Matei77/RootKB/README.md

# RootKB - By Matei Ionescu

You can read about the project at: https://ocw.cs.pub.ro/courses/pm/prj2024/ccontasel/matei.ionescu0703

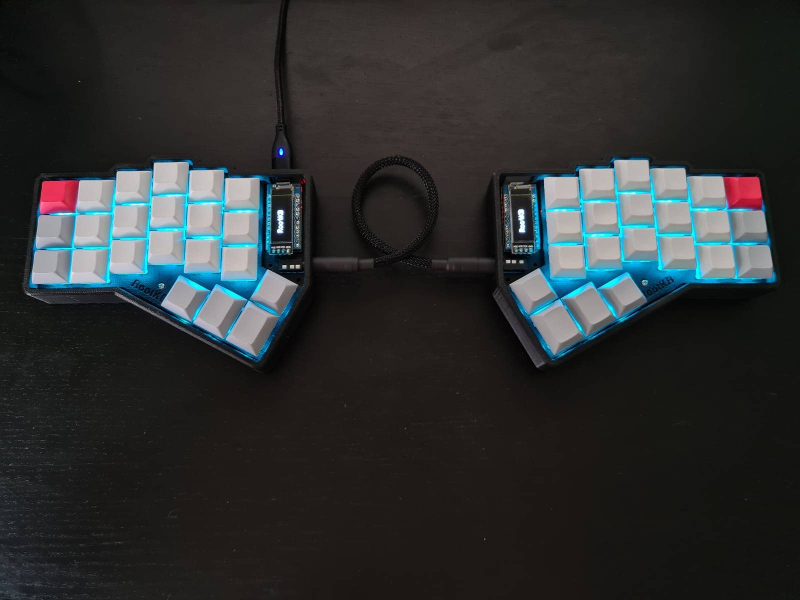
[picture p1: docs/images/final-result.jpeg]
keyboard
