Matei77/RootKB/Characters-Layout/keyboard-layout.png

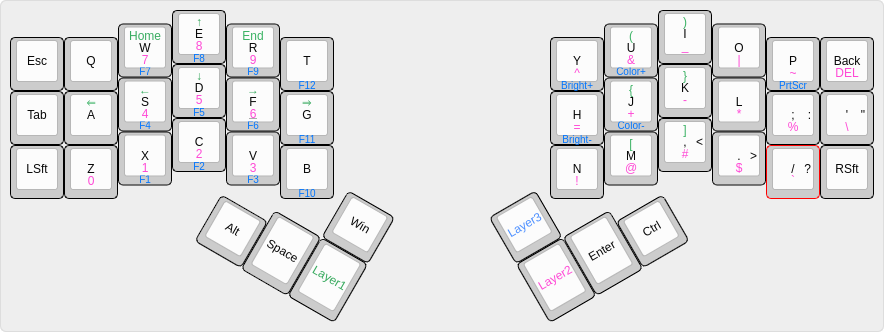
Characters-Layout/keyboard-layout.png
