Matei77/RootKB/docs/images/Block-diagram.png

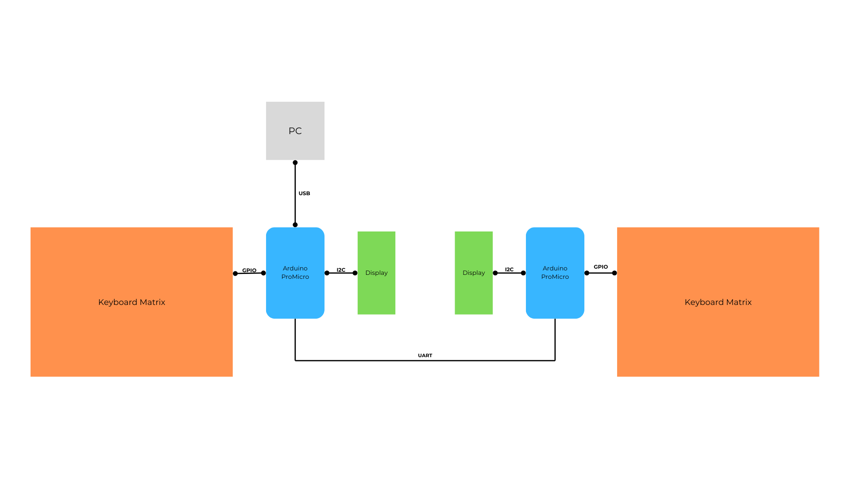
docs/images/Block-diagram.png
