Matei77/RootKB/docs/images/Case-Left.png

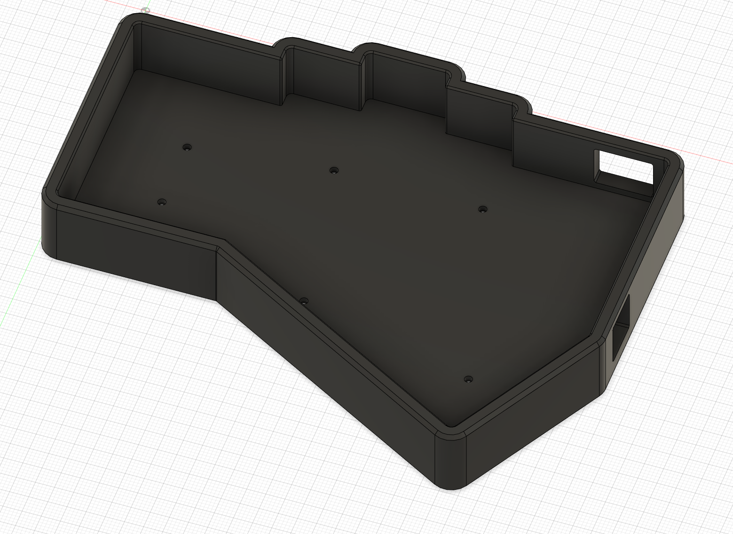
docs/images/Case-Left.png
