Matei77/RootKB/docs/images/Case-Right.png

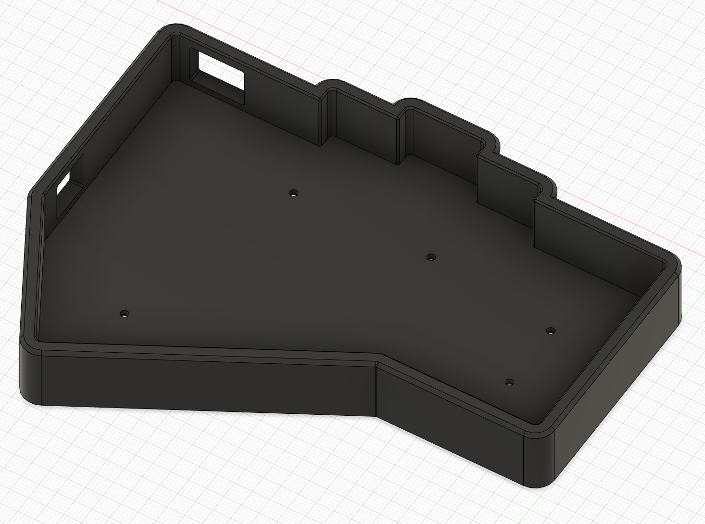
docs/images/Case-Right.png
