Matei77/RootKB/docs/images/ergogen-layout.png

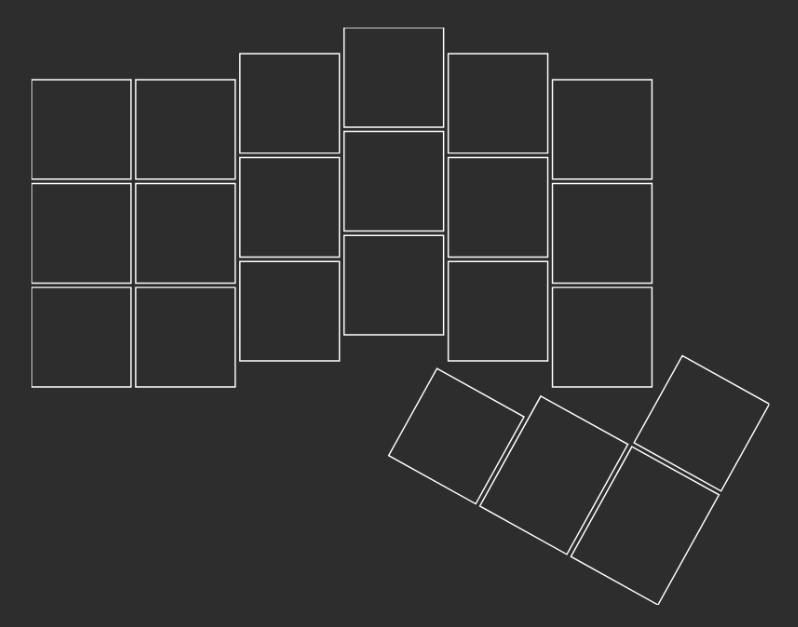
docs/images/ergogen-layout.png
