Matei77/RootKB/docs/images/final-keys-layout.jpeg

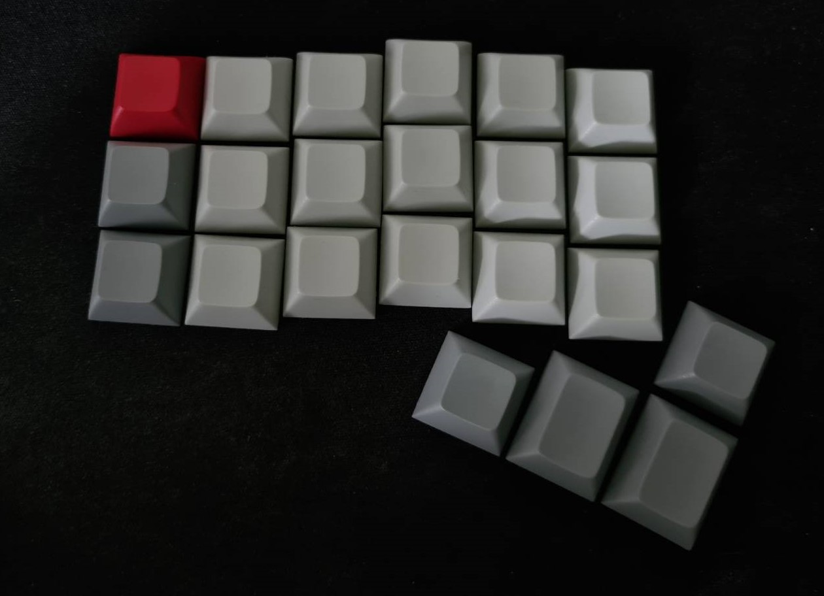
docs/images/final-keys-layout.jpeg
