Matei77/RootKB/docs/images/gantt.png

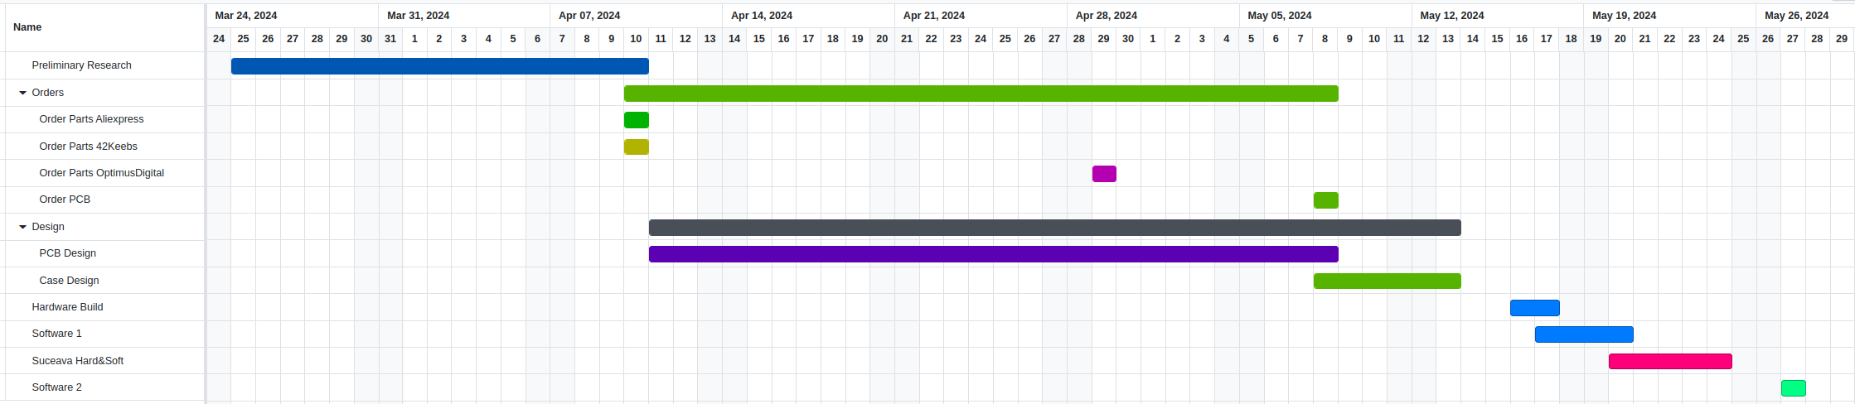
docs/images/gantt.png
