Matei77/RootKB/docs/images/layout-trail-1.jpeg

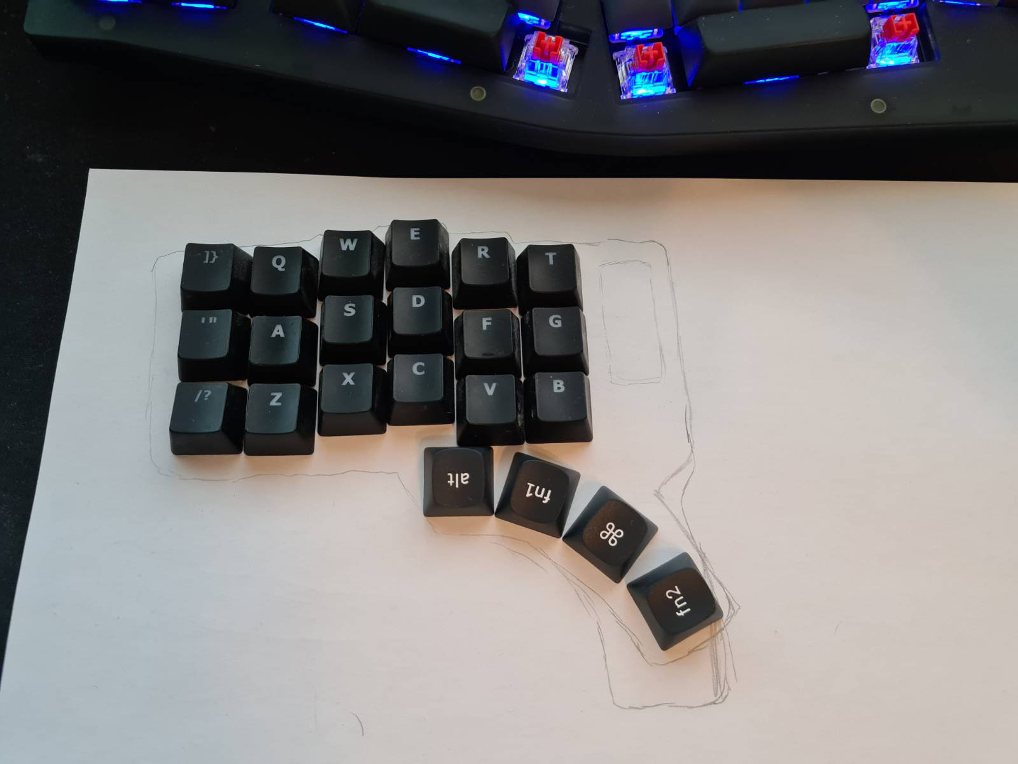
docs/images/layout-trail-1.jpeg
