Matei77/RootKB/docs/images/layout-trail-2.jpeg

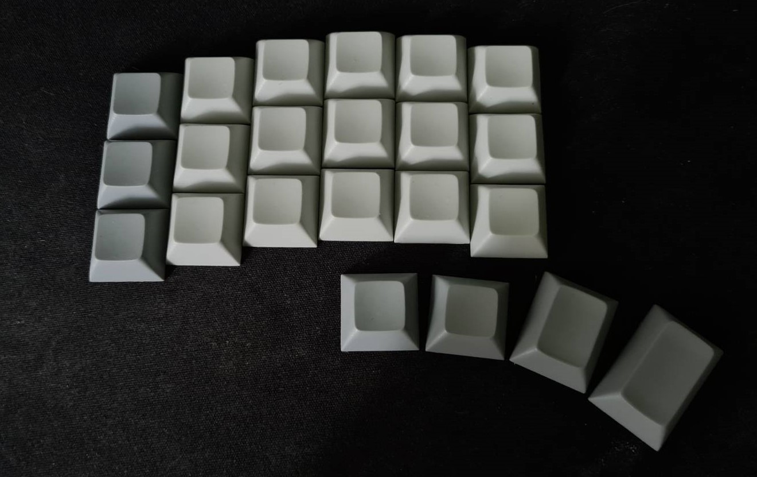
docs/images/layout-trail-2.jpeg
