Matei77/RootKB/docs/images/measuring-layout.jpeg

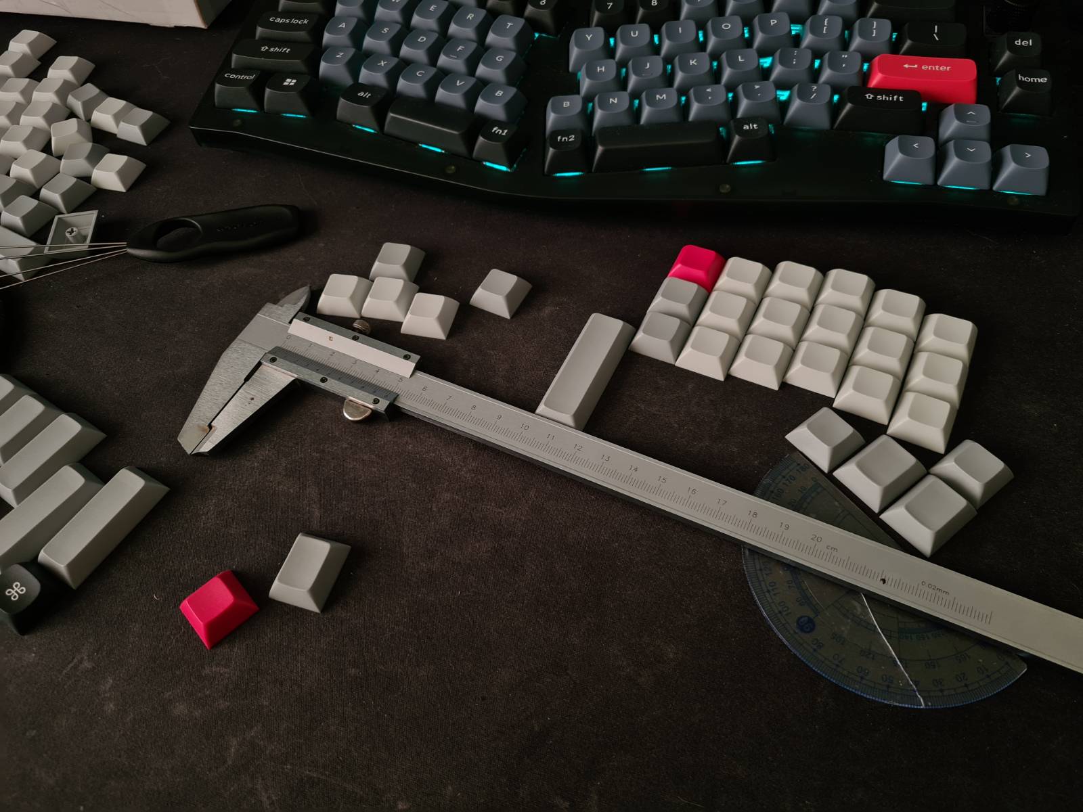
docs/images/measuring-layout.jpeg
