Matei77/RootKB/docs/images/PCB-Left-Back.png

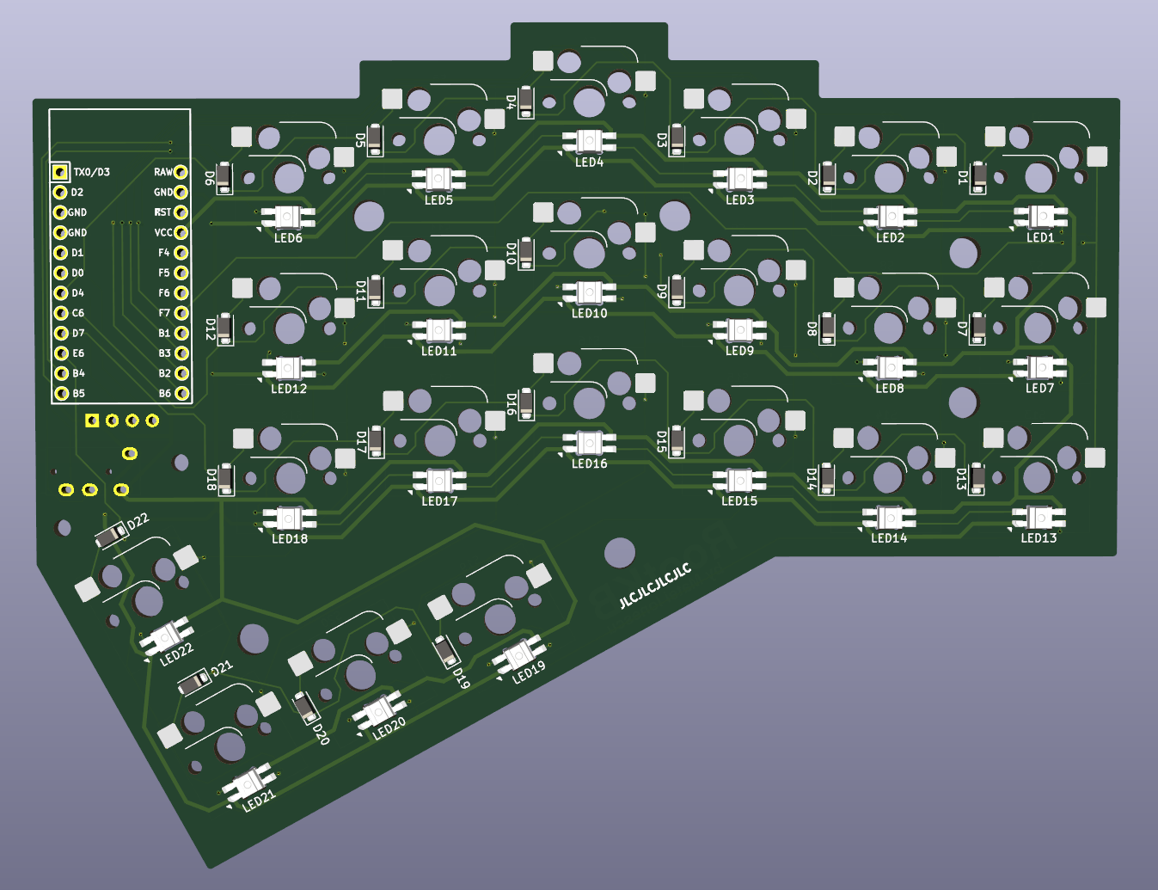
docs/images/PCB-Left-Back.png
