Matei77/RootKB/docs/images/PCB-Left-Front.png

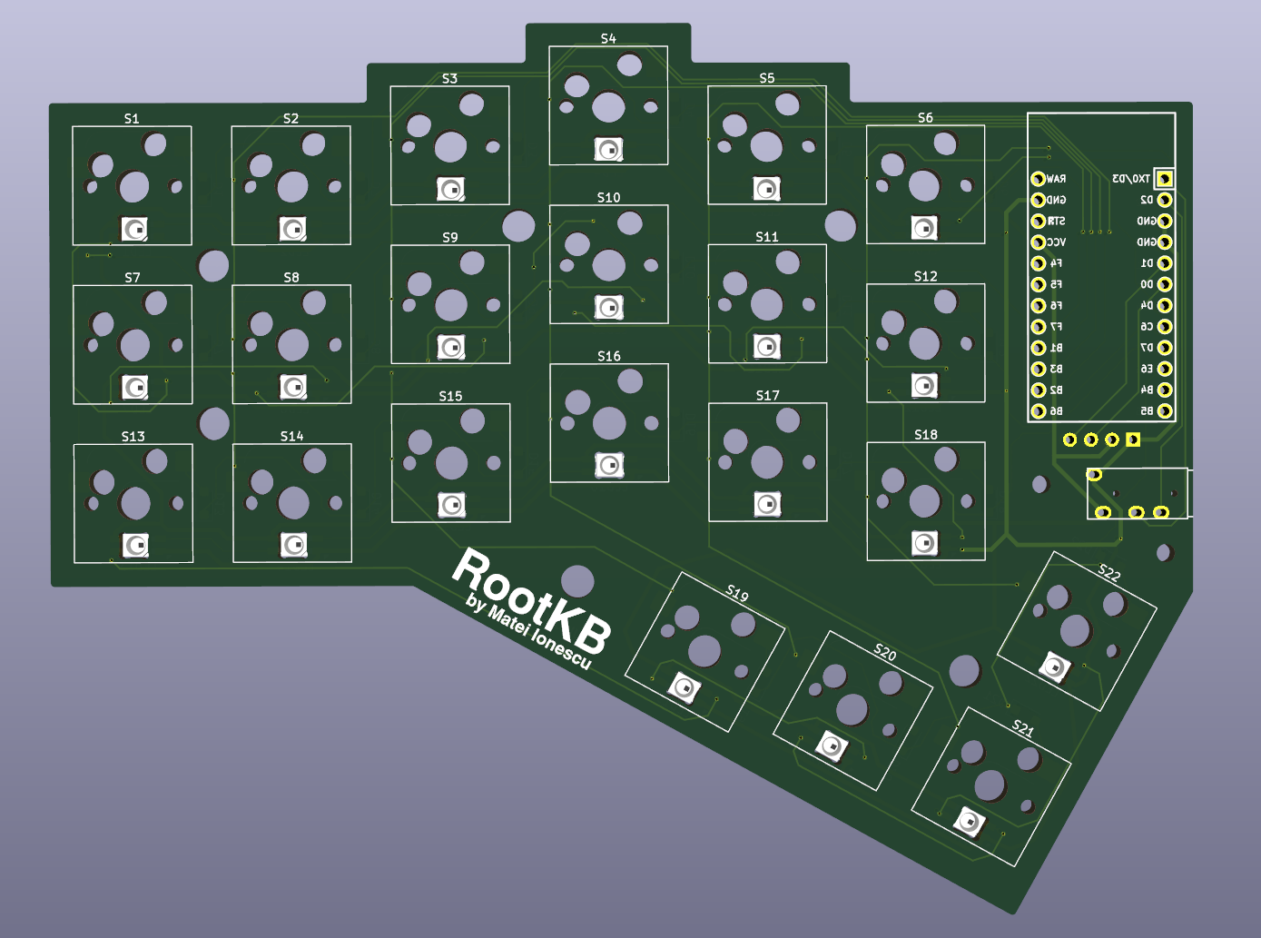
docs/images/PCB-Left-Front.png
