Matei77/RootKB/docs/images/PCB-Left.png

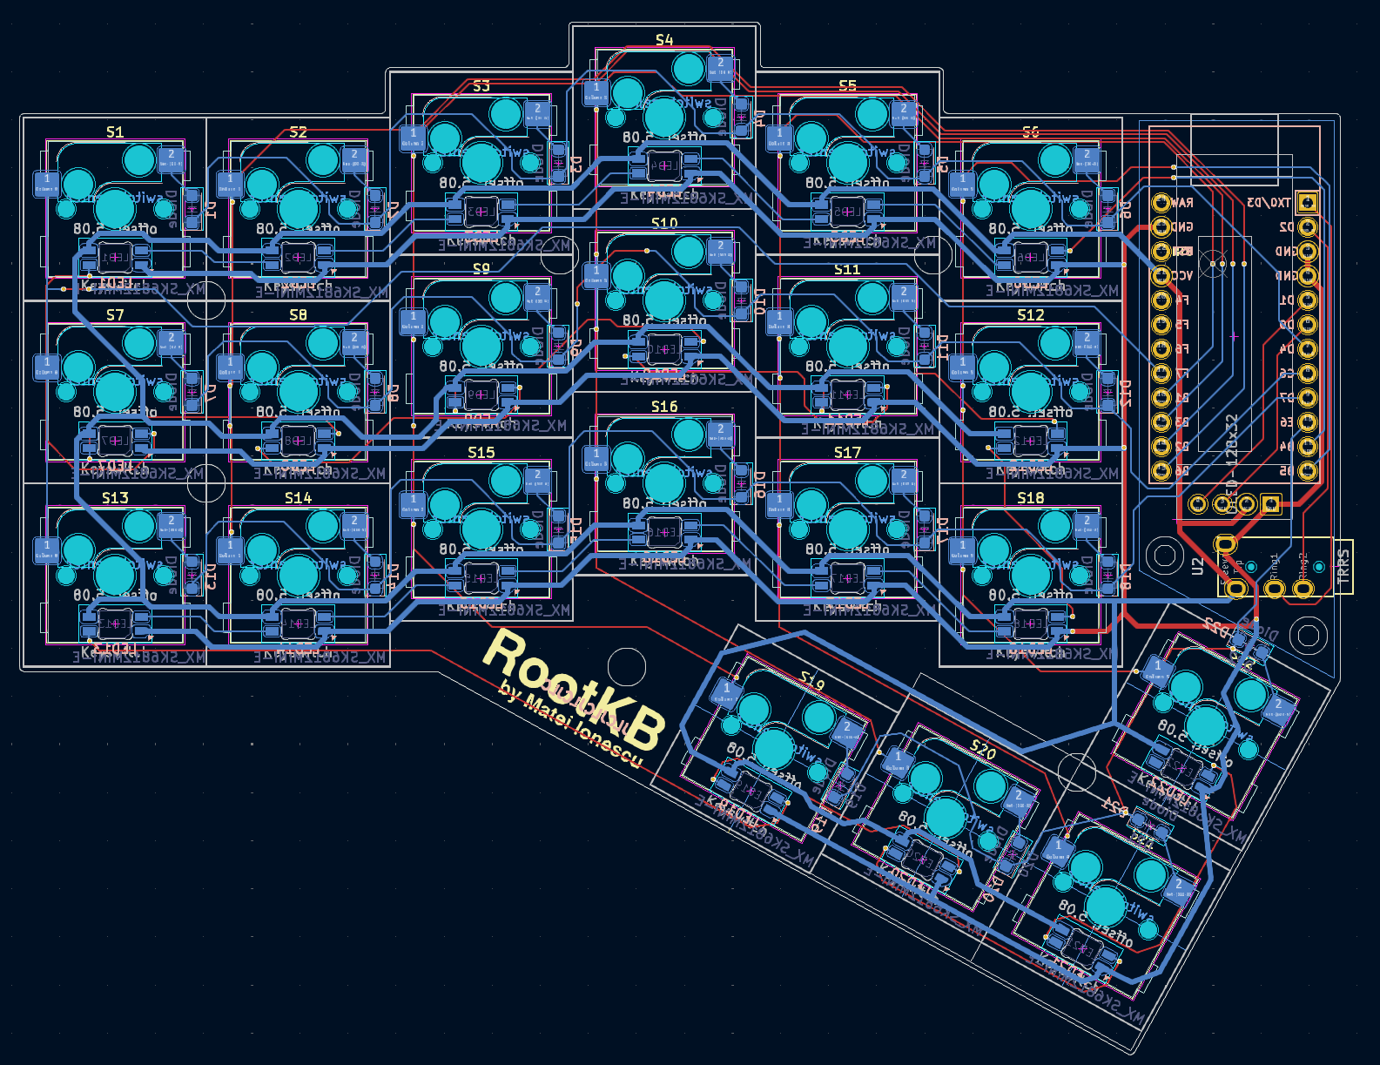
docs/images/PCB-Left.png
