Matei77/RootKB/docs/images/PCB-Right-Back.png

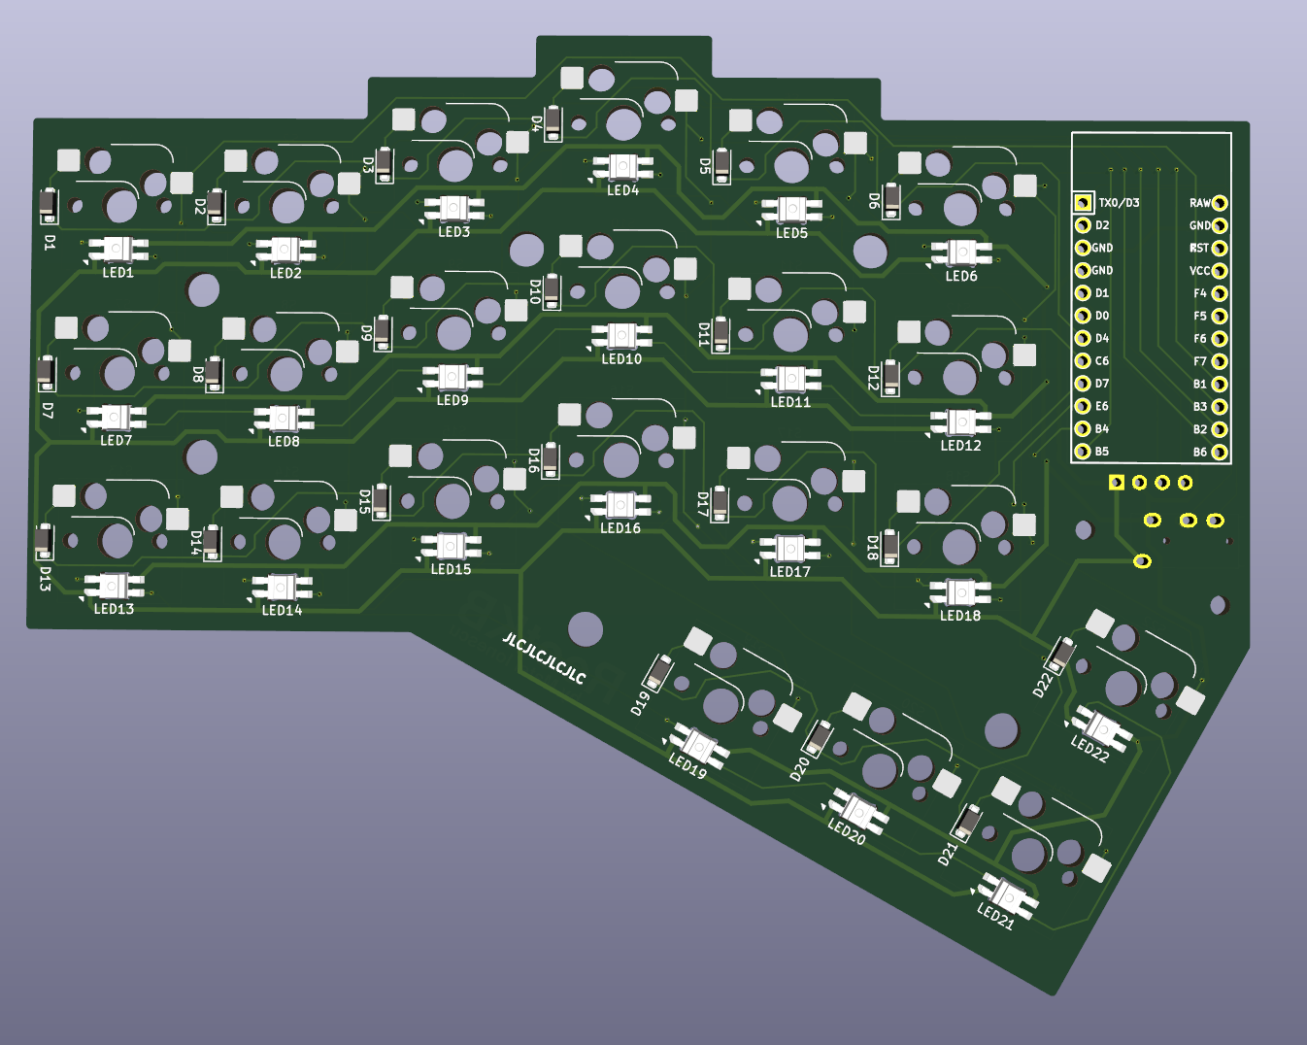
docs/images/PCB-Right-Back.png
