Matei77/RootKB/docs/images/PCB-Right-Front.png

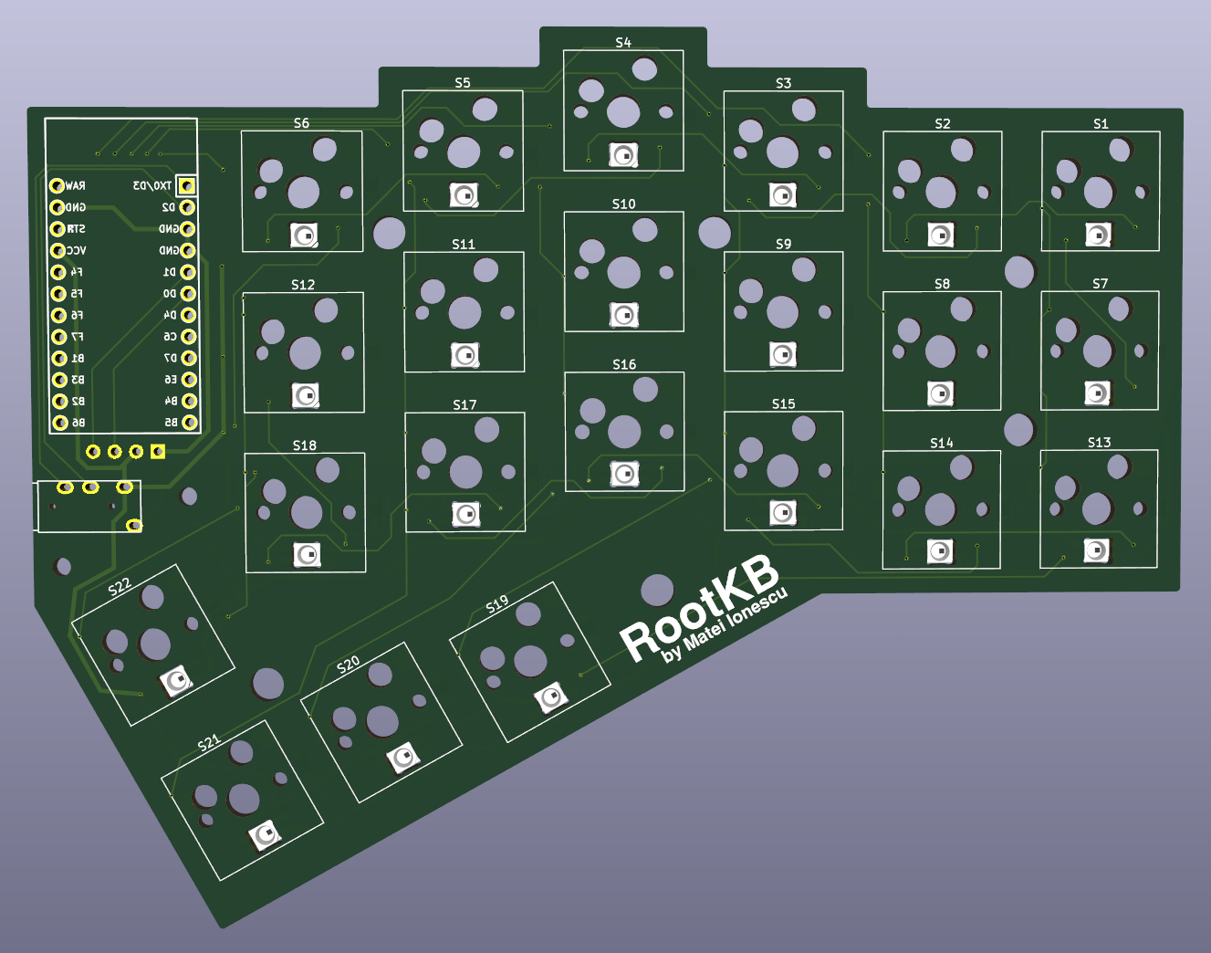
docs/images/PCB-Right-Front.png
