Matei77/RootKB/docs/images/PCB-Right.png

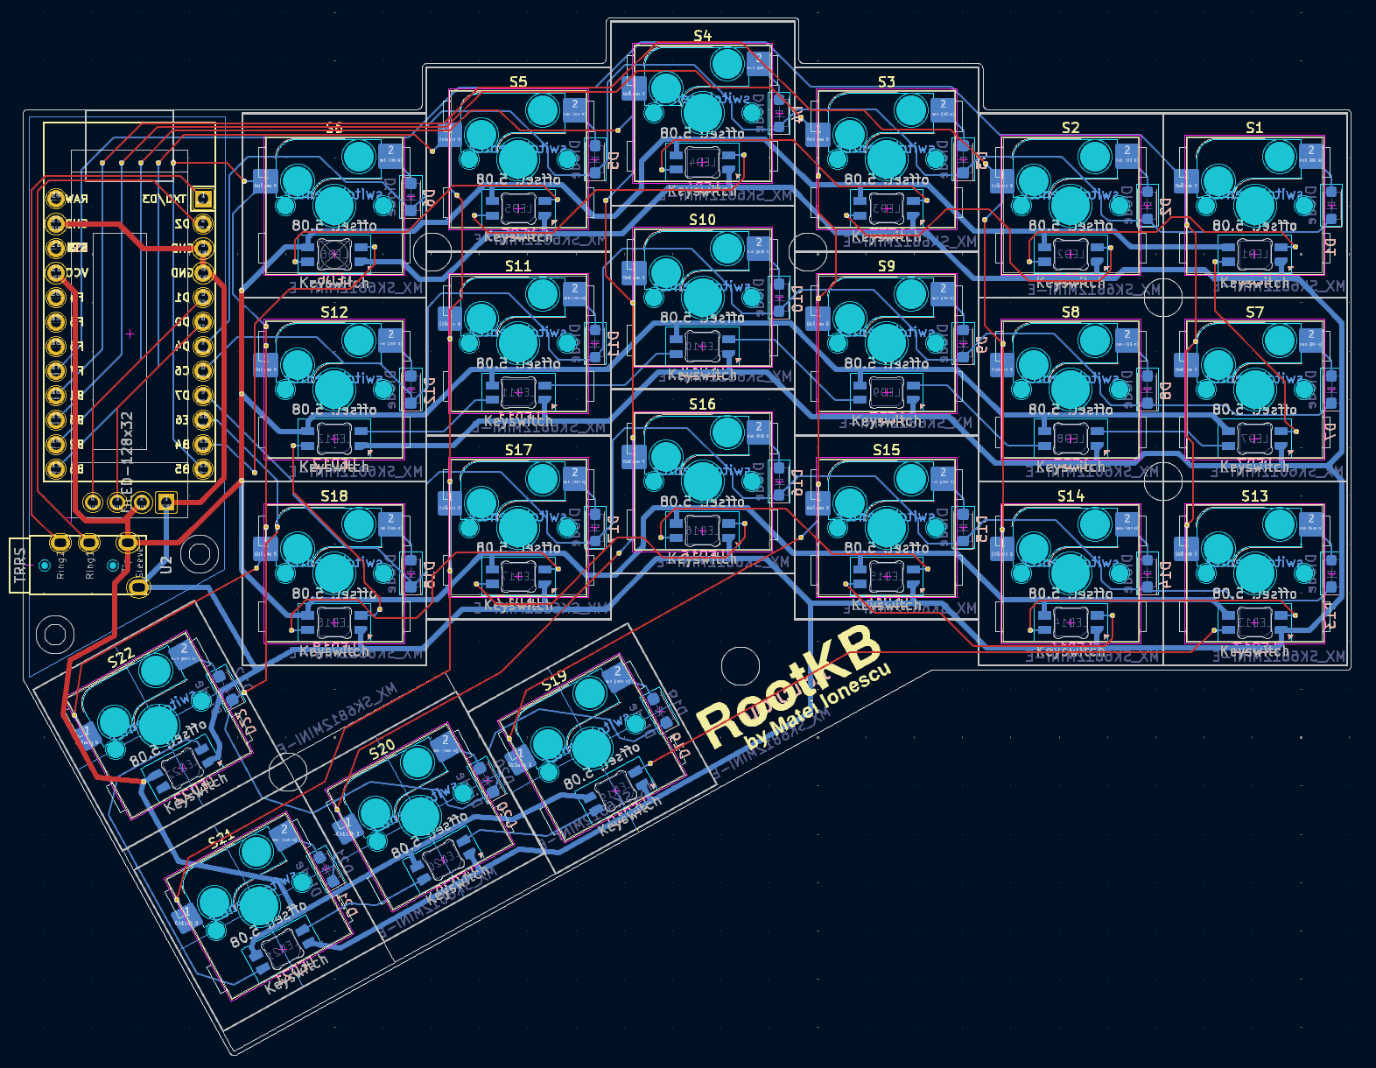
docs/images/PCB-Right.png
