Matei77/RootKB/docs/images/physical-pcbs.jpeg

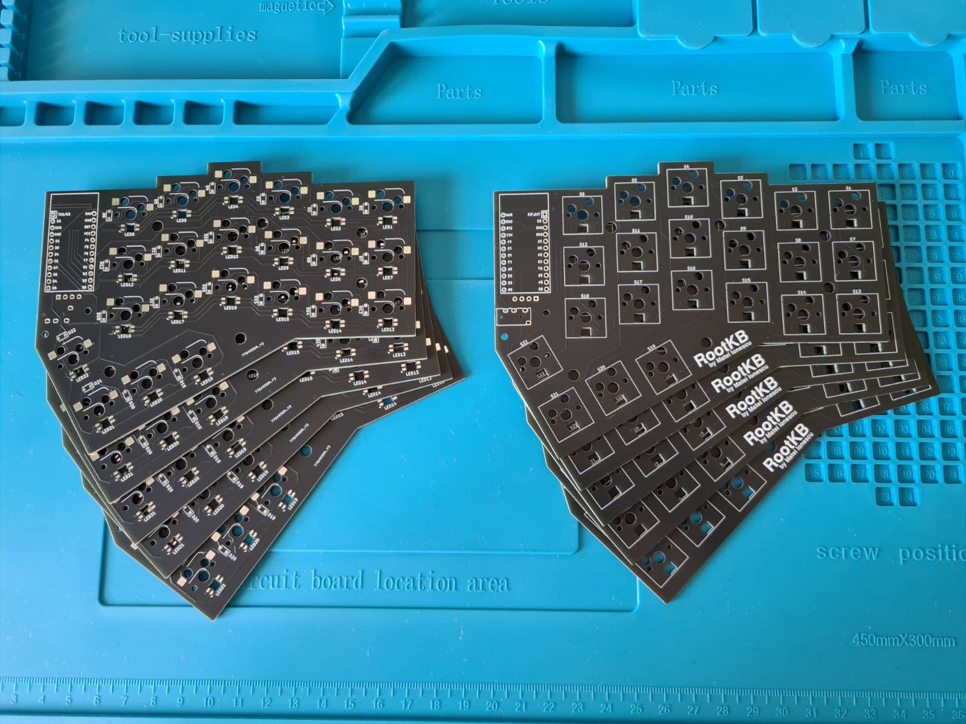
docs/images/physical-pcbs.jpeg
