Matei77/RootKB/docs/images/Plate-Left.png

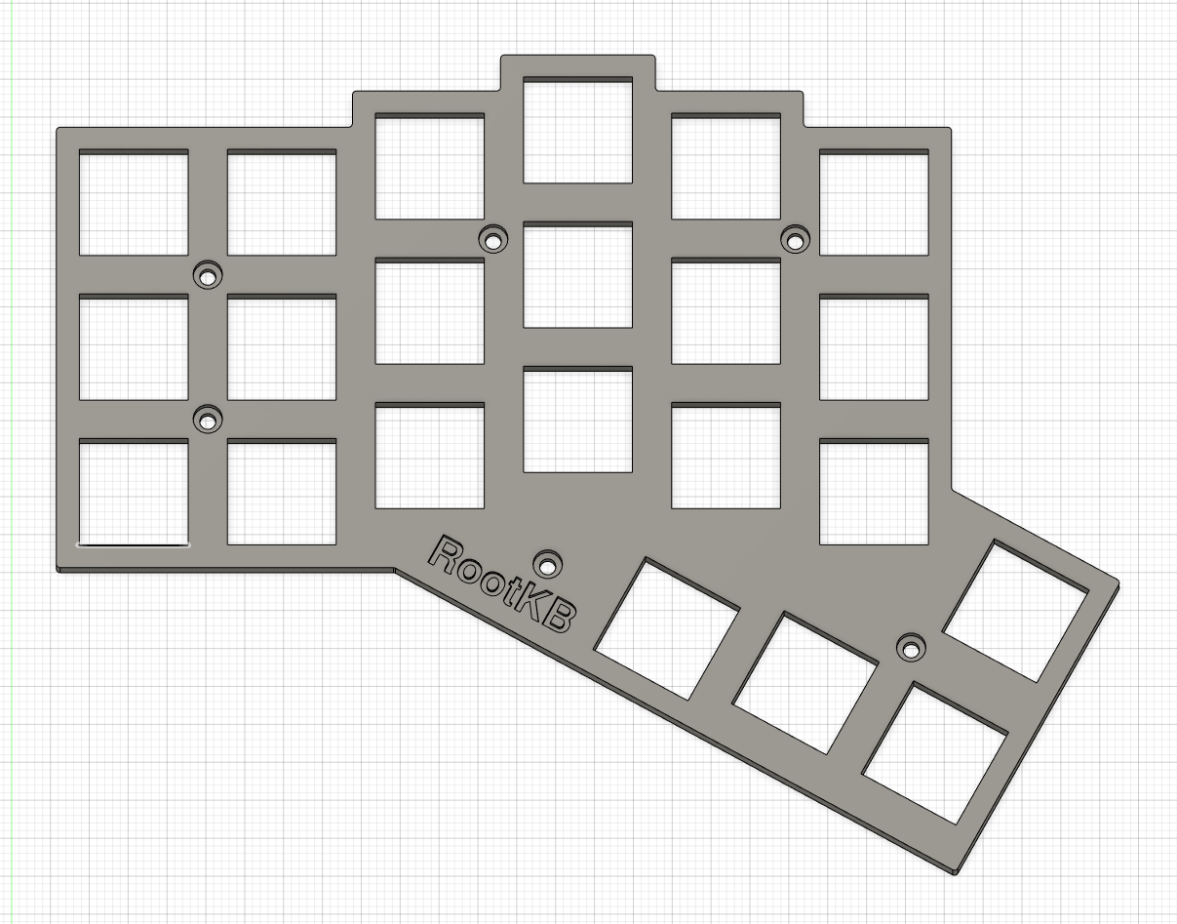
docs/images/Plate-Left.png
