Matei77/RootKB/docs/images/Plate-Right.png

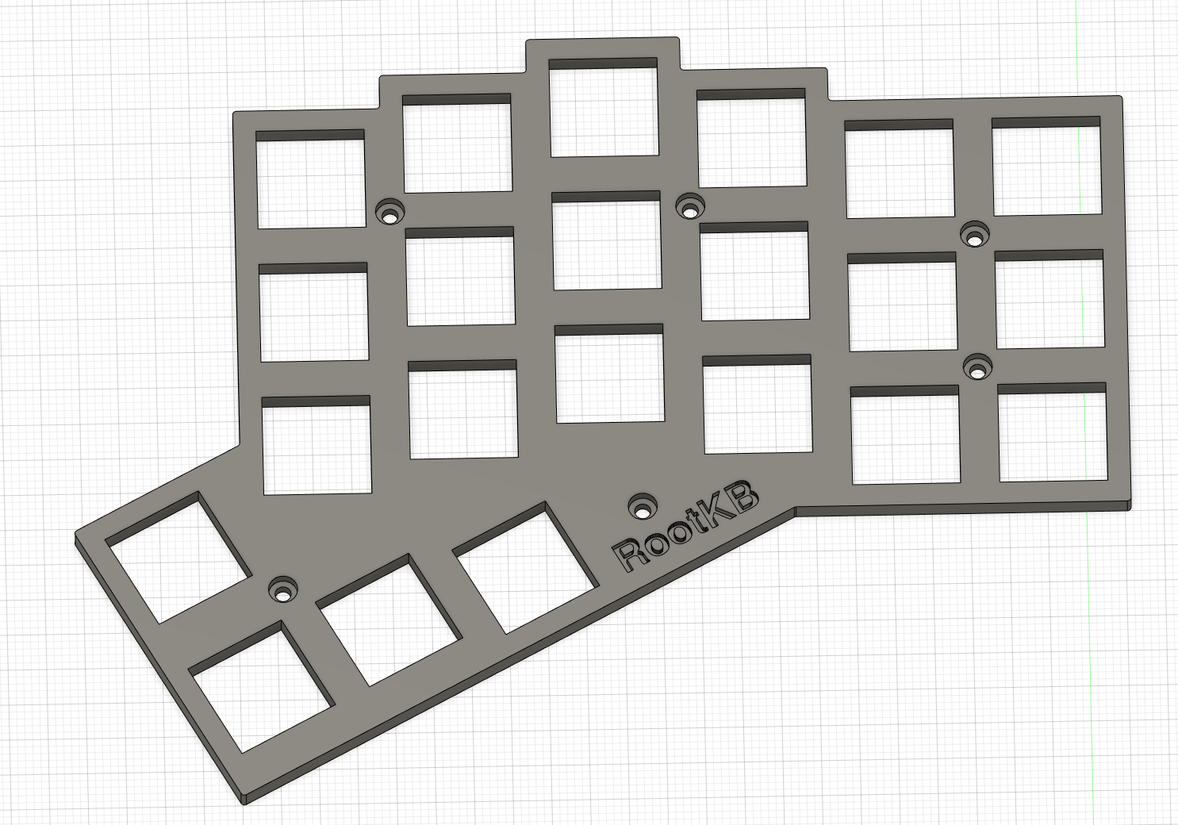
docs/images/Plate-Right.png
