Matei77/RootKB/docs/images/Remington_2_typewriter_keyboard-1878.jpg

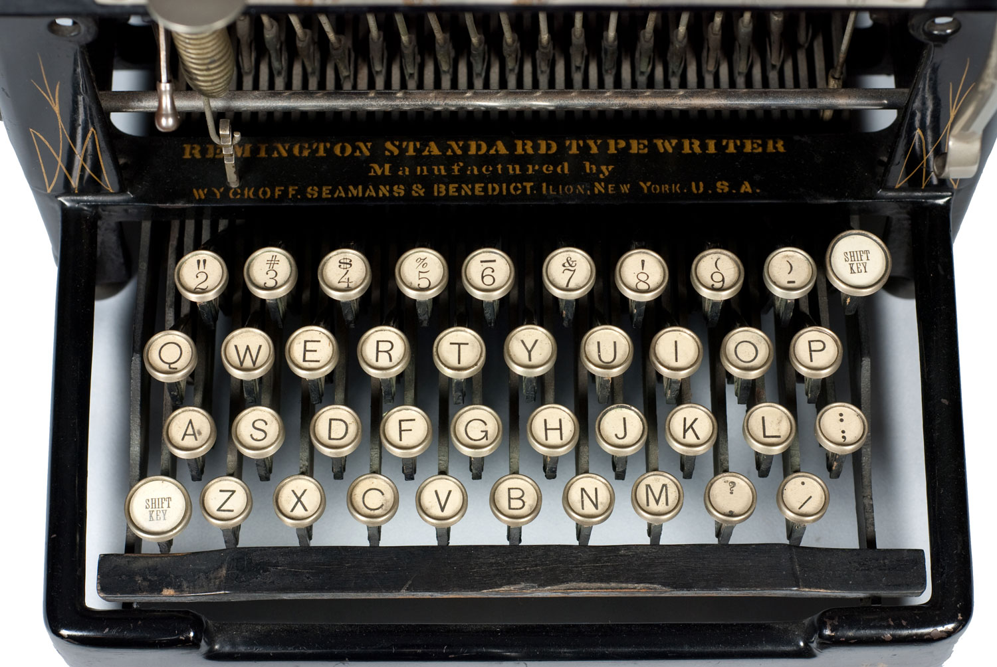
docs/images/Remington_2_typewriter_keyboard-1878.jpg
