Matei77/RootKB/docs/images/Schematic-Left.png

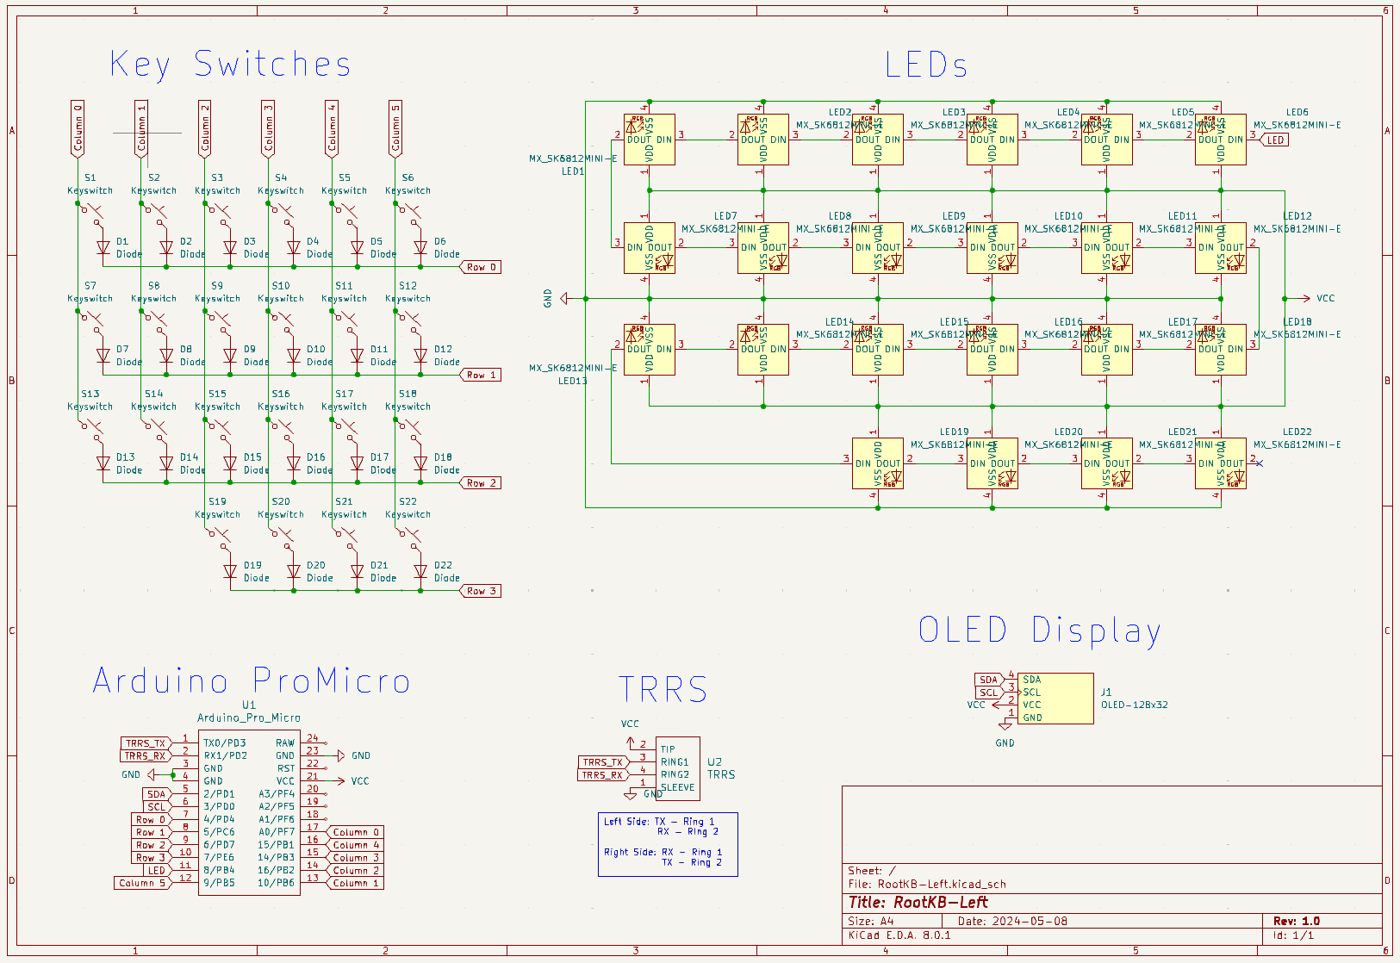
docs/images/Schematic-Left.png
