Matei77/RootKB/docs/images/Schematic-Right.png

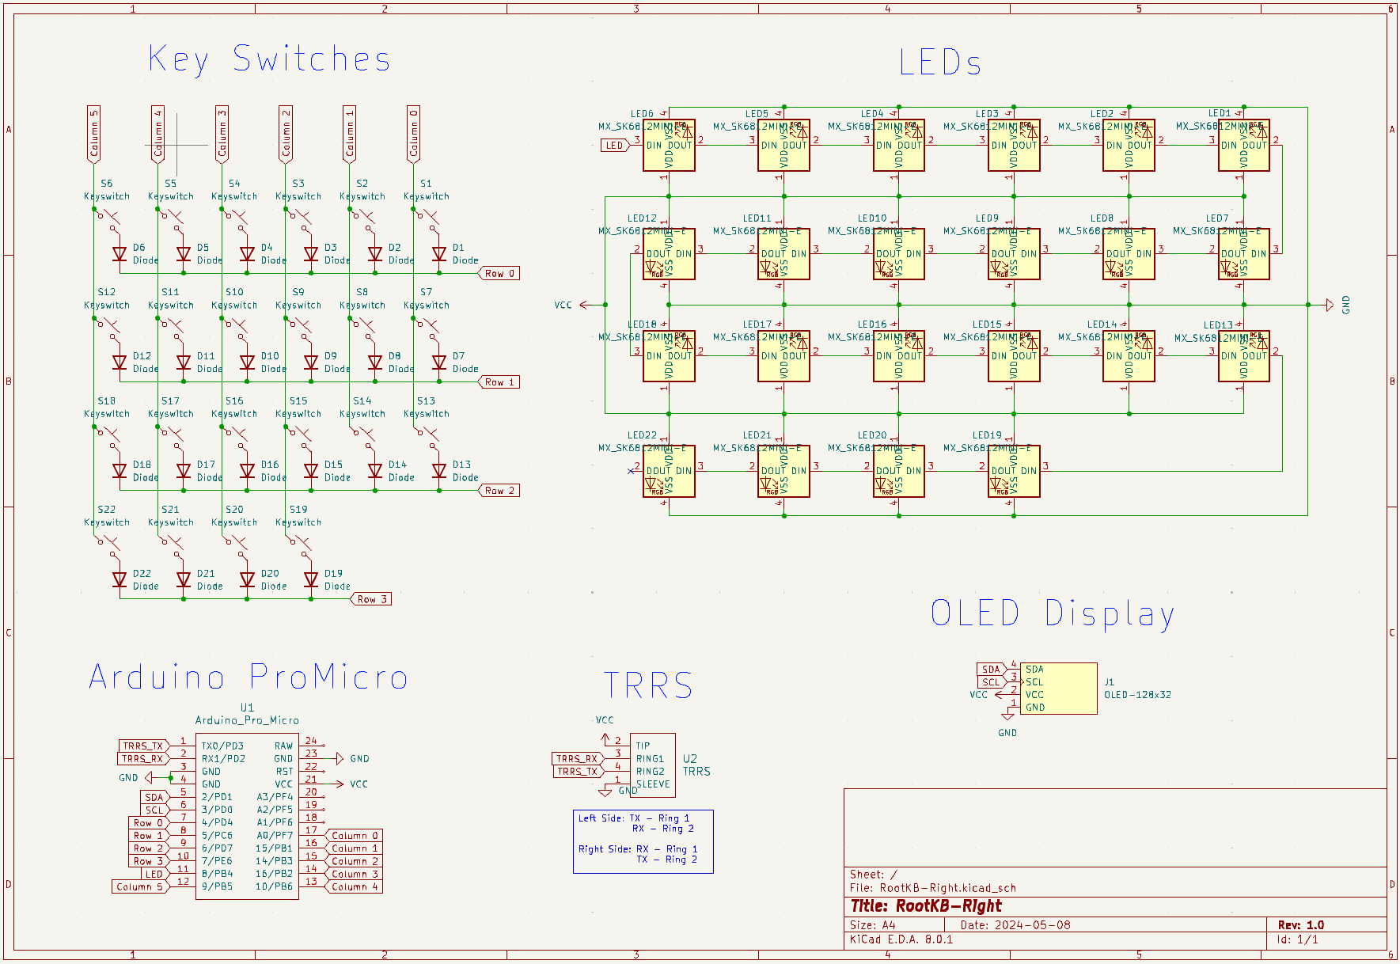
docs/images/Schematic-Right.png
