Matei77/RootKB/docs/images/split.jpg

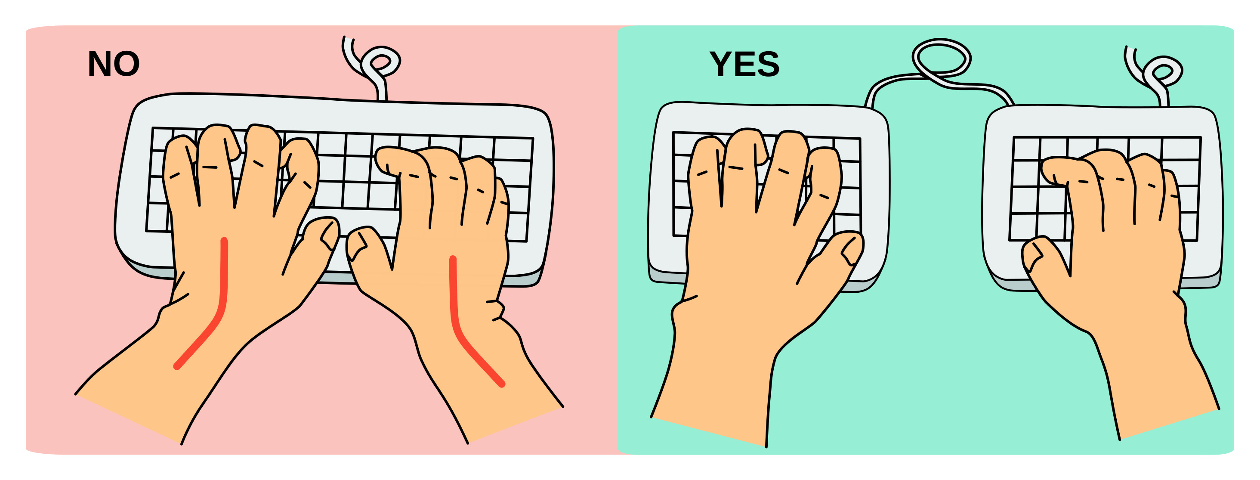
docs/images/split.jpg
