Matei77/RootKB/docs/images/stagger.jpg

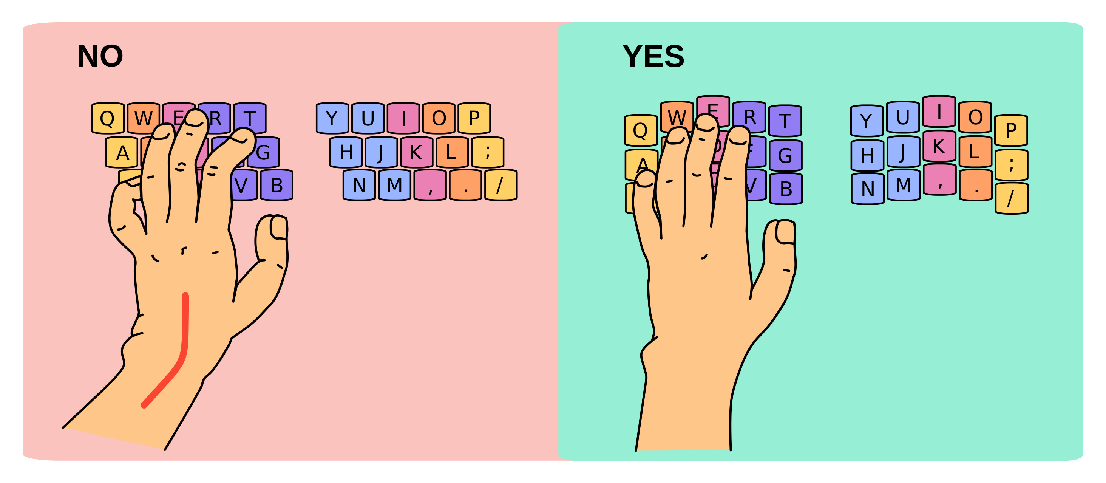
docs/images/stagger.jpg
