Matei77/RootKB/docs/images/thumb-cluster.jpg

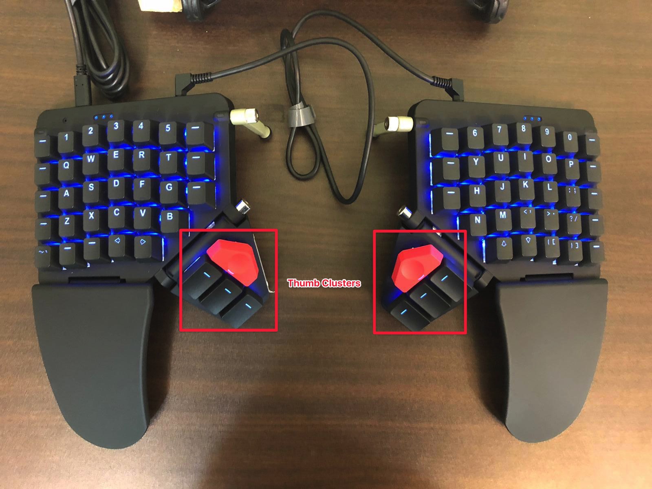
docs/images/thumb-cluster.jpg
