Matei77/RootKB/Casing/All 3D Print/RootKB-Right-Case v3.stl

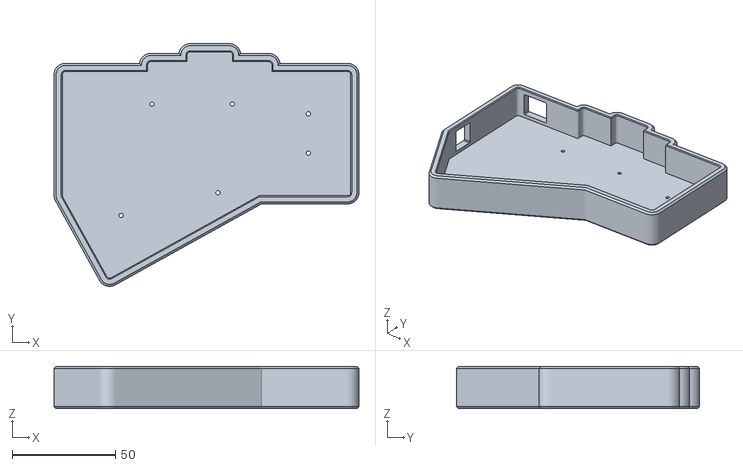
[picture p27: CAD file, 2024-05-12]
Casing/All 3D Print/RootKB-Right-Case v3.stl
147.4 x 117.4 x 20.5
