Matei77/RootKB/Casing/Plate/3D/RootKB-Plate v7.step

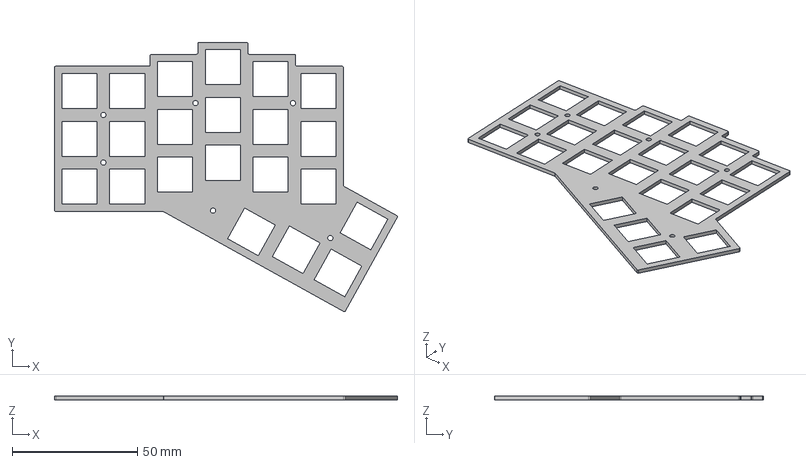
[picture p28: CAD file, 2024-05-11]
Casing/Plate/3D/RootKB-Plate v7.step
136.8 x 107.4 x 1.50 mm
