Matei77/RootKB/Casing/Plate/Left/RootKB-3D-Print-Plate-Left v1.stl

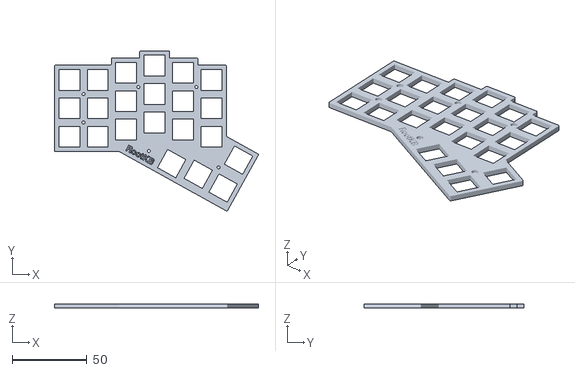
[picture p29: CAD file, 2024-05-12]
Casing/Plate/Left/RootKB-3D-Print-Plate-Left v1.stl
136.8 x 107.4 x 3.00
