Matei77/RootKB/Casing/Plate/Useful/RootKB-Plate v8.dxf

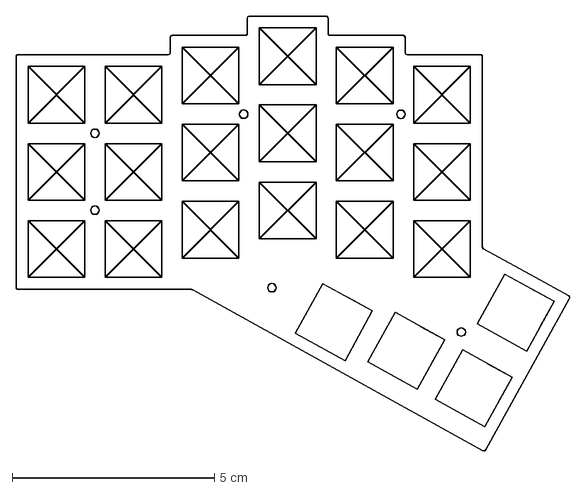
[picture p30: CAD file, 2024-05-12]
Casing/Plate/Useful/RootKB-Plate v8.dxf
13.7 x 10.7 cm
