Matei77/RootKB/Ergogen/plate.dxf

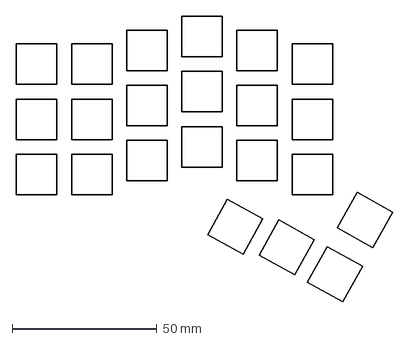
[picture p31: CAD file, 2024-05-12]
Ergogen/plate.dxf
130.0 x 98.6 mm
