Matei77/RootKB/PCB/KiCad Project/RootKB-Left/exports/RootKB-Left-User_Drawings.dxf

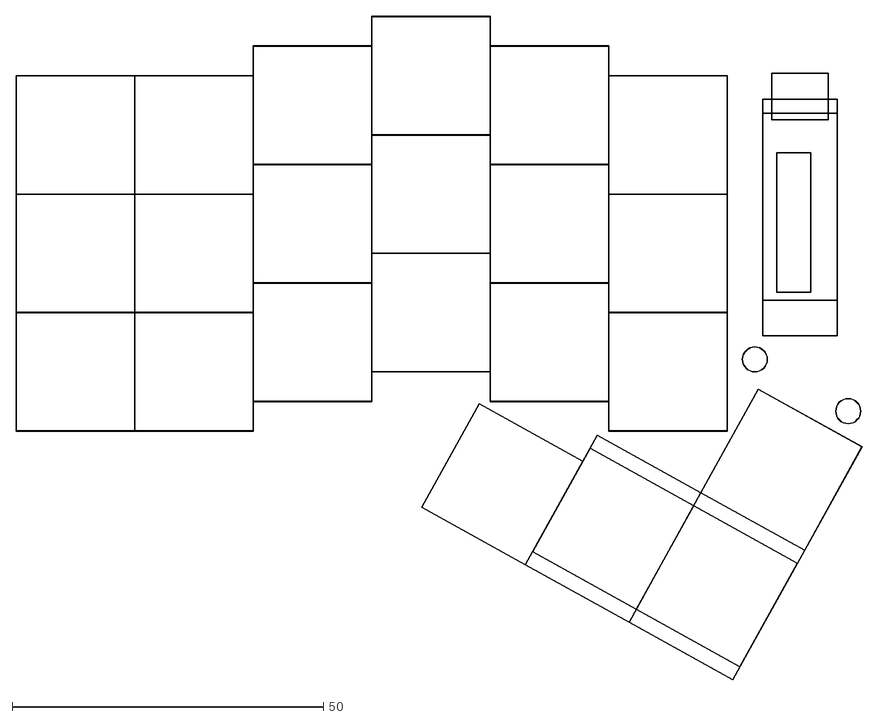
[picture p32: CAD file, 2024-05-11]
PCB/KiCad Project/RootKB-Left/exports/RootKB-Left-User_Drawings.dxf
135.9 x 106.6
