Matei77/RootKB/PCB/KiCad Project/RootKB-Right/exports/RootKB-Right-Edge_Cuts.dxf

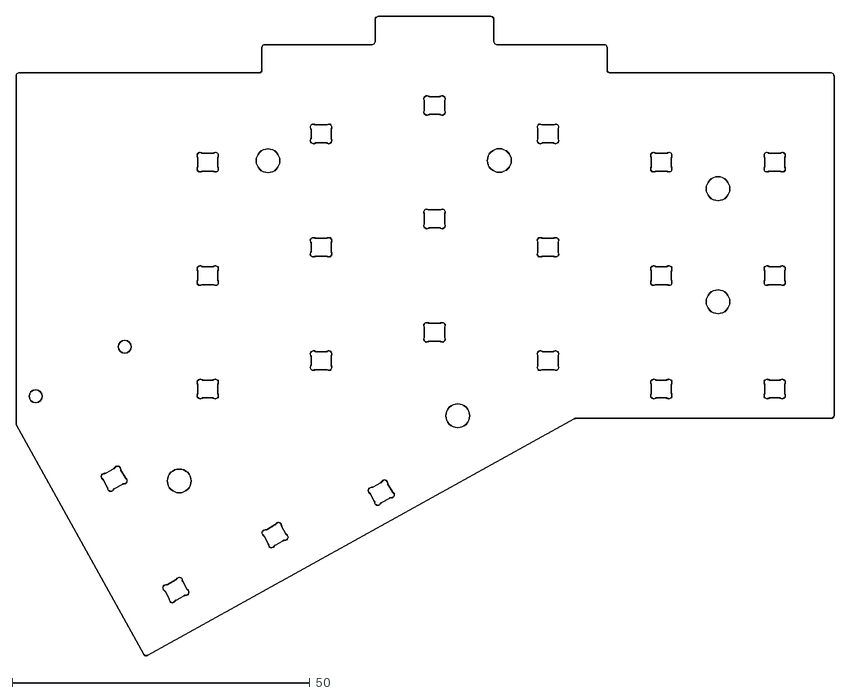
[picture p33: CAD file, 2024-05-12]
PCB/KiCad Project/RootKB-Right/exports/RootKB-Right-Edge_Cuts.dxf
137.4 x 107.4
