Matei77/RootKB/Ergogen/keys.dxf

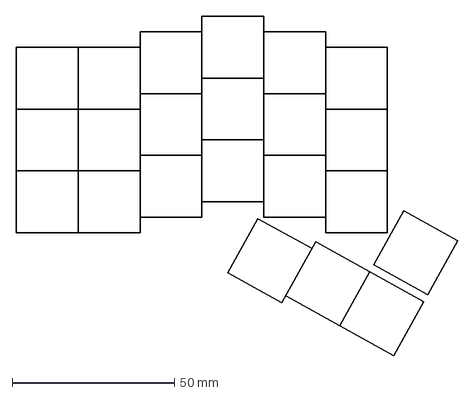
[picture p34: CAD file, 2024-05-12]
Ergogen/keys.dxf
135.9 x 104.6 mm
