Matei77/RootKB/PCB/KiCad Project/RootKB-Left/exports/RootKB-Left-F_Courtyard.dxf

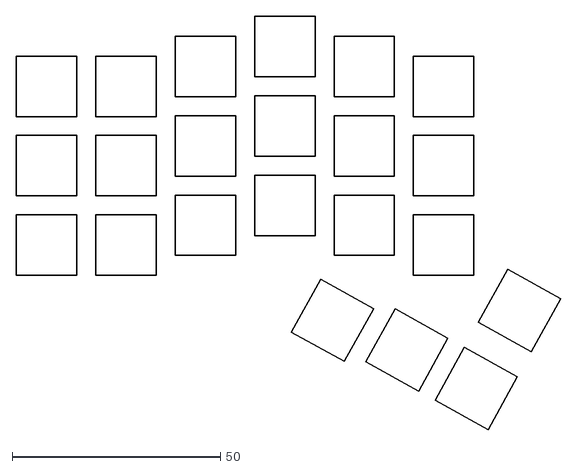
[picture p35: CAD file, 2024-05-11]
PCB/KiCad Project/RootKB-Left/exports/RootKB-Left-F_Courtyard.dxf
130.5 x 99.2
