Matei77/RootKB/Ergogen/base_layout.dxf

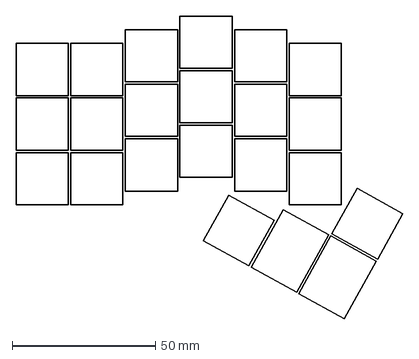
[picture p36: CAD file, 2024-05-12]
Ergogen/base_layout.dxf
134.9 x 105.7 mm
