Matei77/RootKB/PCB/KiCad Project/RootKB-Left/exports/RootKB-Left-Edge_Cuts.dxf

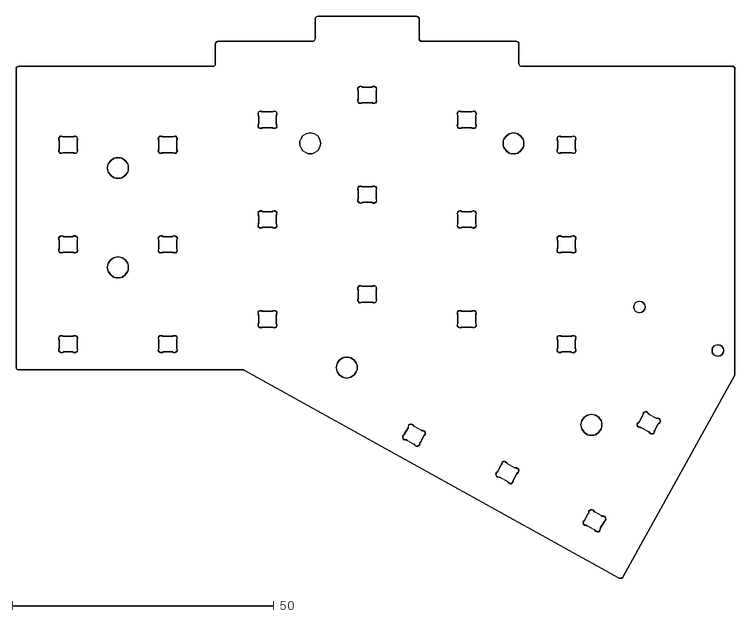
[picture p37: CAD file, 2024-05-11]
PCB/KiCad Project/RootKB-Left/exports/RootKB-Left-Edge_Cuts.dxf
137.4 x 107.4
