Matei77/RootKB/(list of files, cad)

Other CAD files:
Casing/Case/Left/RootKB-Left-Case v9.step
Casing/Case/Right/RootKB-Right-Case v2.step
Casing/Plate/Sym/2D/RootKB-Plate v8.dwg
Casing/Plate/Sym/3D/RootKB-Plate v8.step
Casing/All 3D Print/RootKB-3D-Print-Plate-Right v1.stl
Casing/Plate/Right/RootKB-3D-Print-Plate-Right v1.stl
Casing/Plate/Sym/2D/annotated_plate.dwg
Casing/All 3D Print/RootKB-Left-Case v9.stl
Casing/Plate/Sym/2D/plate-silkscreen.dwg
Casing/Case/Left/RootKB-Left-Case v9.stl
Casing/Plate/Right/RootKB-3D-Print-Plate-Right v0.stl
Casing/Plate/Useful/RootKB-Plate v7.dxf
Casing/Plate/Useful/RootKB-Plate v8.dwg
PCB/KiCad Project/RootKB-Left/exports/RootKB-Left-F_Silkscreen.dxf
