Matei77/RootKB/docs/images/Build-Left.png

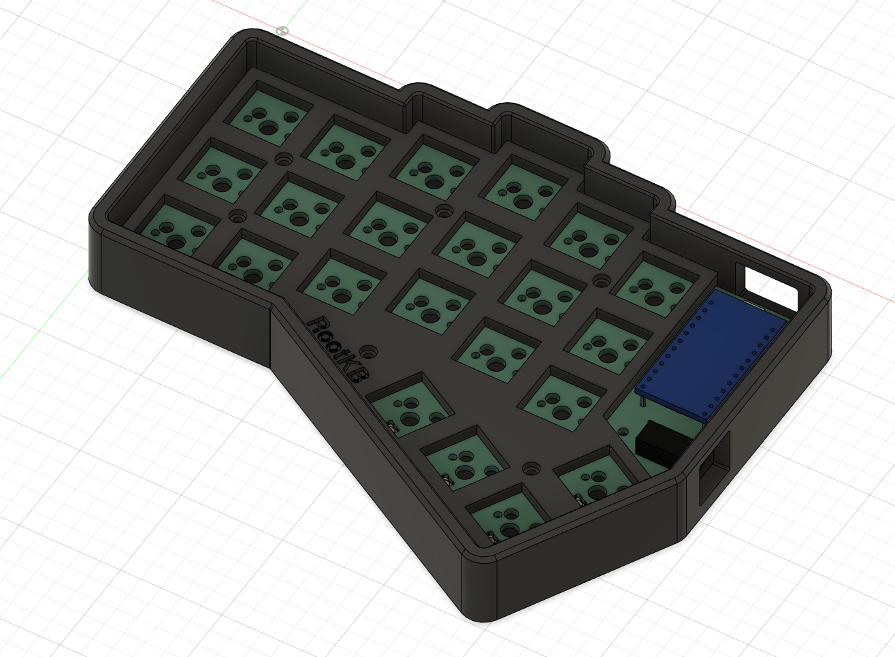
docs/images/Build-Left.png
