Matei77/RootKB/docs/images/case_3d_printed.jpeg

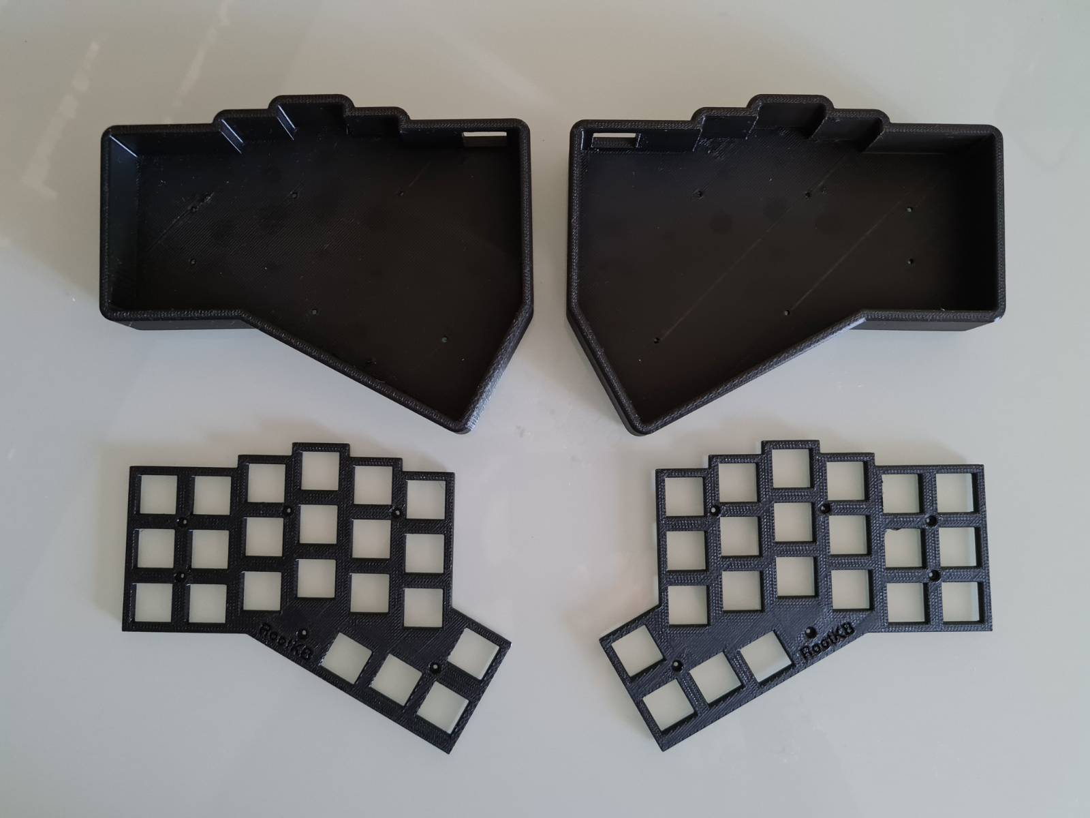
docs/images/case_3d_printed.jpeg
