Matei77/RootKB/docs/images/half-build.jpeg

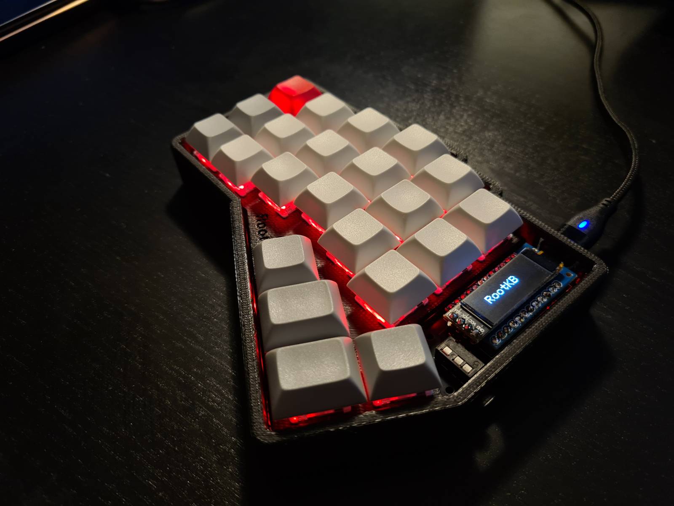
docs/images/half-build.jpeg
