Matei77/RootKB/docs/images/solder-pcb.jpeg

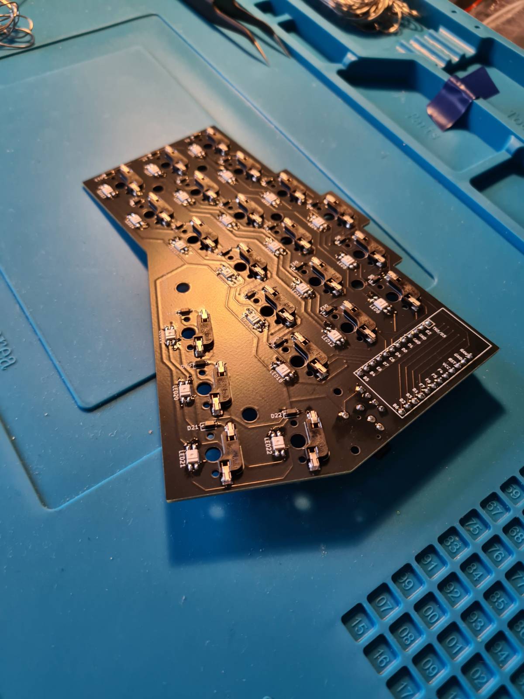
docs/images/solder-pcb.jpeg
