Matei77/RootKB/docs/images/solder-setup.jpeg

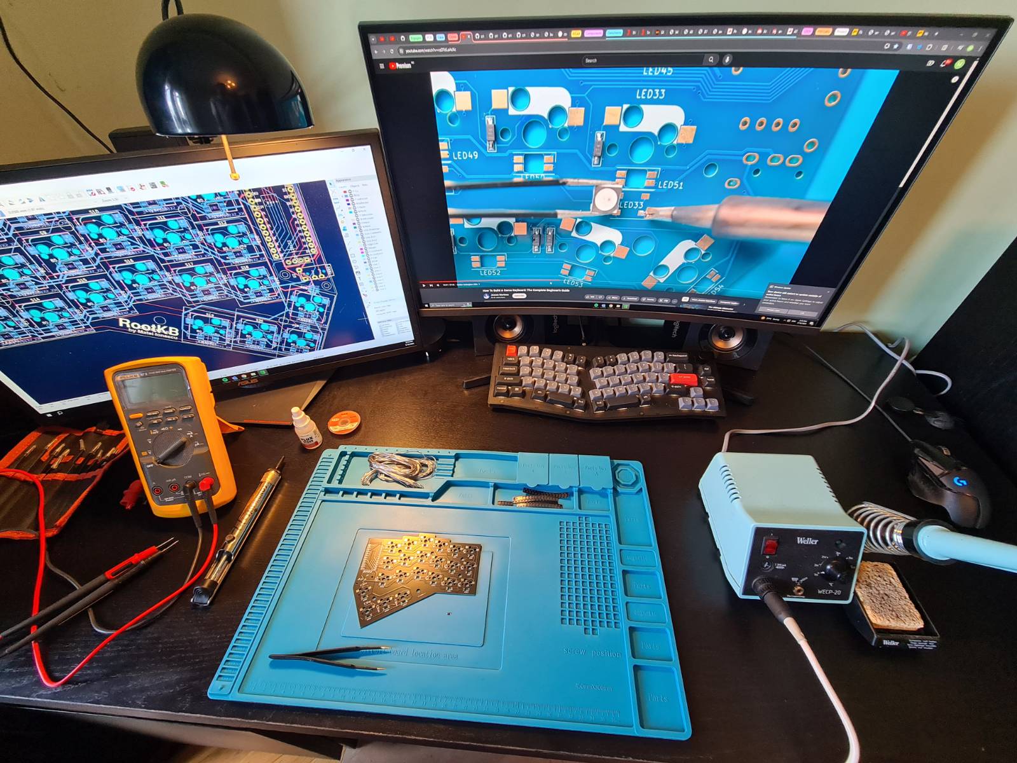
docs/images/solder-setup.jpeg
