Matei77/RootKB/PCB/KiCad Project/RootKB-Left/RootKB-Left.kicad_pcb

## KiCad design PCB/KiCad Project/RootKB-Left/RootKB-Left.kicad_pcb (2024-05-08)

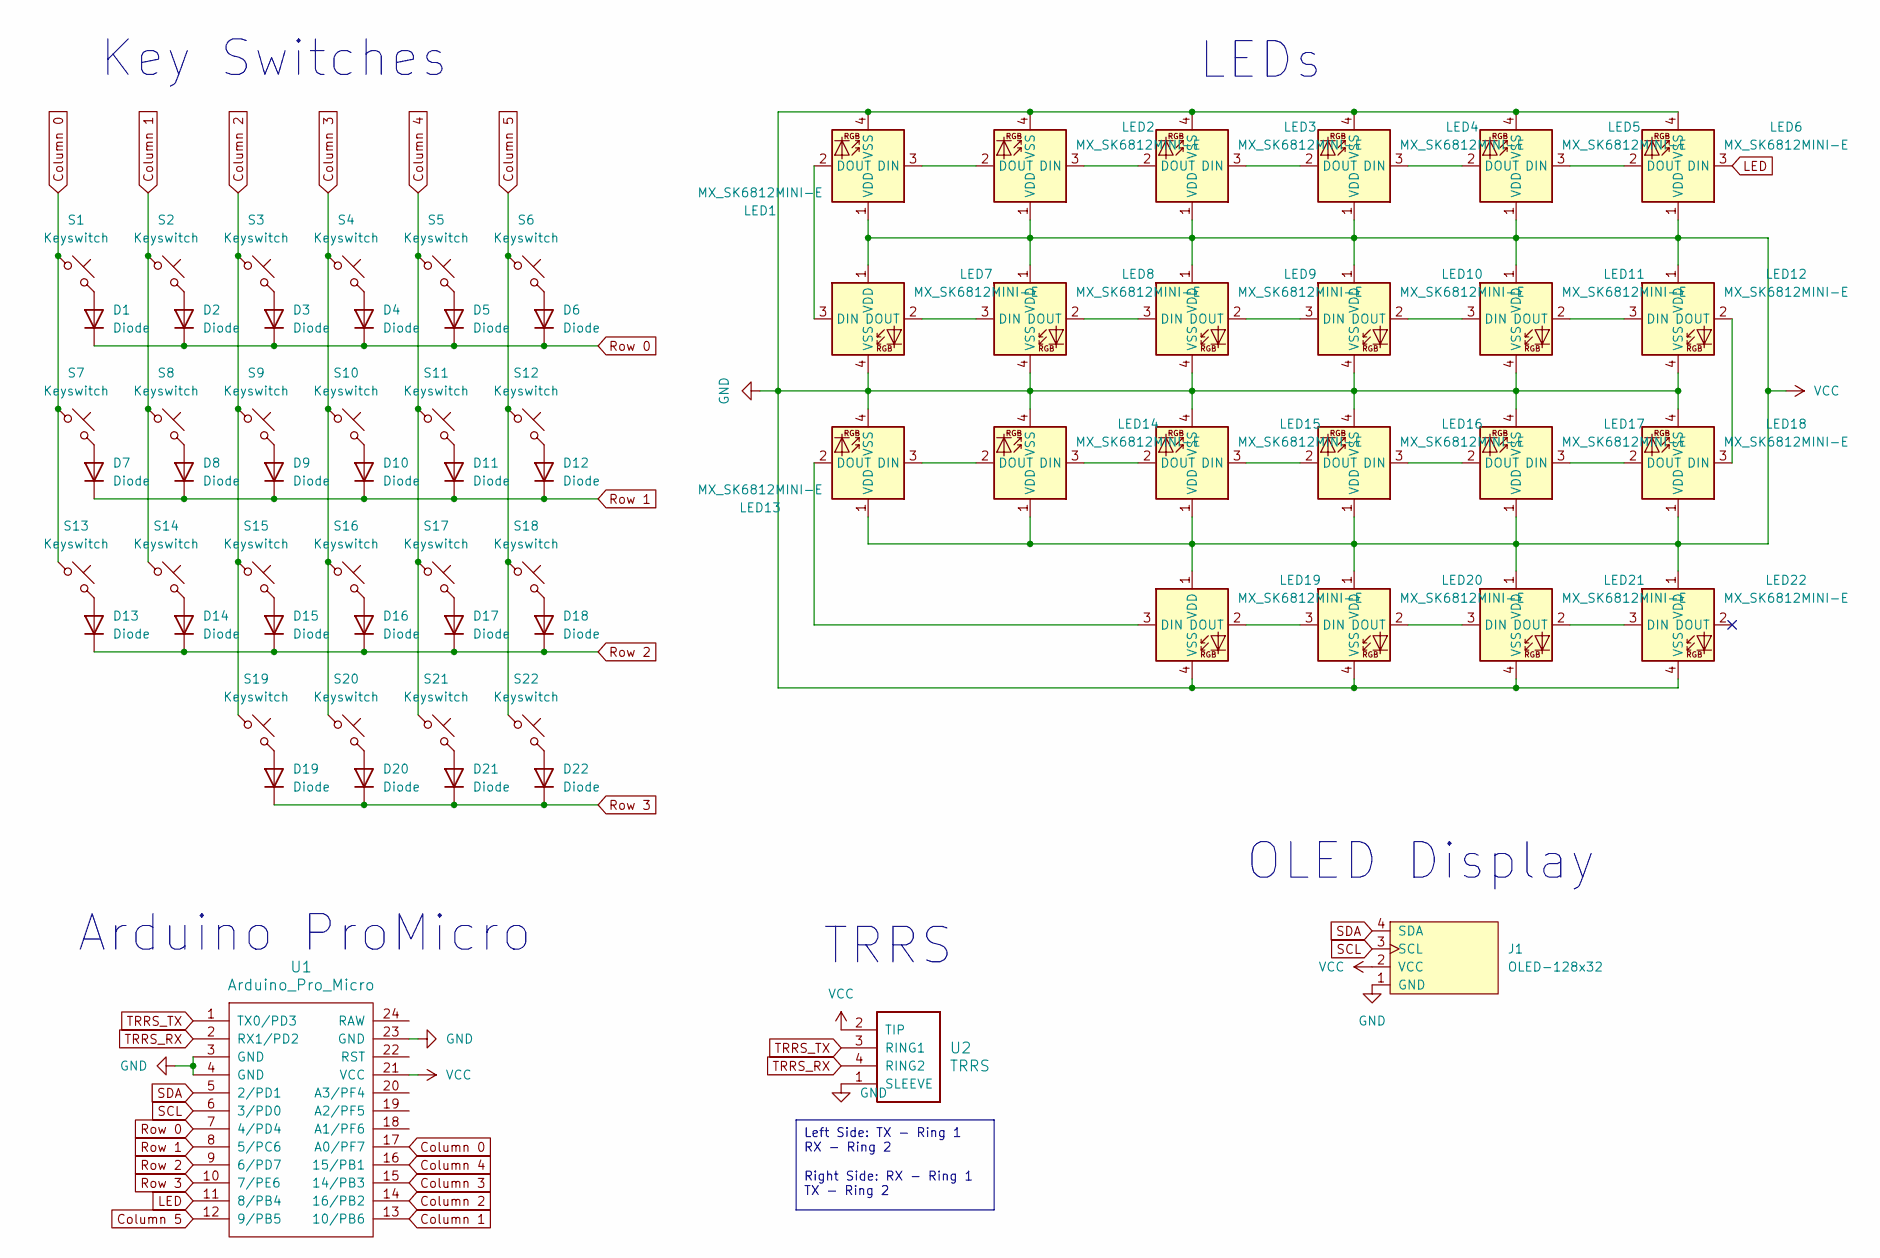
[picture p43: schematic RootKB-Left.kicad_sch]

Parts:
D1, D2, D3, D4, D5, D6, D7, D8, D9, D10, D11, D12, D13, D14, D15, D16, D17, D18, D19, D20, D21, D22: Diode; D_SOD-123F
J1: OLED-128x32; OLED-128x32-cutout
LED1, LED2, LED3, LED4, LED5, LED6, LED7, LED8, LED9, LED10, LED11, LED12, LED13, LED14, LED15, LED16, LED17, LED18, LED19, LED20, LED21, LED22: MX_SK6812MINI-E; LED_MX_6028R
S1, S2, S3, S4, S5, S6, S7, S8, S9, S10, S11, S12, S13, S14, S15, S16, S17, S18, S19, S22: Keyswitch; SW_Hotswap_Kailh_MX_1.00u
S20, S21: Keyswitch; SW_Hotswap_Kailh_MX_1.25u_90deg
U1: Arduino_Pro_Micro
U2: TRRS; TRRS_PJ-320A

Connections:
Column 0: S1.1, S7.1, S13.1, U1.17 (A0/PF7)
Column 1: S2.1, S8.1, S14.1, U1.13 (10/PB6)
Column 2: S3.1, S9.1, S15.1, S19.1, U1.14 (16/PB2)
Column 3: S4.1, S10.1, S16.1, S20.1, U1.15 (14/PB3)
Column 4: S5.1, S11.1, S17.1, S21.1, U1.16 (15/PB1)
Column 5: S6.1, S12.1, S18.1, S22.1, U1.12 (9/PB5)
GND: J1.1 (GND), LED1.4 (VSS), LED2.4 (VSS), LED3.4 (VSS), LED4.4 (VSS), LED5.4 (VSS), LED6.4 (VSS), LED7.4 (VSS), LED8.4 (VSS), LED9.4 (VSS), LED10.4 (VSS), LED11.4 (VSS), LED12.4 (VSS), LED13.4 (VSS), LED14.4 (VSS), LED15.4 (VSS), LED16.4 (VSS), LED17.4 (VSS), LED18.4 (VSS), LED19.4 (VSS), LED20.4 (VSS), LED21.4 (VSS), LED22.4 (VSS), U1.3 (GND), U1.4 (GND), U1.23 (GND), U2.1 (SLEEVE)
LED: LED6.3 (DIN), U1.11 (8/PB4)
unnamed: D1.2 (A), S1.2
unnamed: D2.2 (A), S2.2
unnamed: D3.2 (A), S3.2
unnamed: D4.2 (A), S4.2
unnamed: D5.2 (A), S5.2
unnamed: D6.2 (A), S6.2
unnamed: D7.2 (A), S7.2
unnamed: D8.2 (A), S8.2
unnamed: D9.2 (A), S9.2
unnamed: D10.2 (A), S10.2
unnamed: D11.2 (A), S11.2
unnamed: D12.2 (A), S12.2
unnamed: D13.2 (A), S13.2
unnamed: D14.2 (A), S14.2
unnamed: D15.2 (A), S15.2
unnamed: D16.2 (A), S16.2
unnamed: D17.2 (A), S17.2
unnamed: D18.2 (A), S18.2
unnamed: D19.2 (A), S19.2
unnamed: D20.2 (A), S20.2
unnamed: D21.2 (A), S21.2
unnamed: D22.2 (A), S22.2
unnamed: LED1.3 (DIN), LED2.2 (DOUT)
unnamed: LED1.2 (DOUT), LED7.3 (DIN)
unnamed: LED2.3 (DIN), LED3.2 (DOUT)
unnamed: LED3.3 (DIN), LED4.2 (DOUT)
unnamed: LED4.3 (DIN), LED5.2 (DOUT)
unnamed: LED5.3 (DIN), LED6.2 (DOUT)
unnamed: LED7.2 (DOUT), LED8.3 (DIN)
unnamed: LED8.2 (DOUT), LED9.3 (DIN)
unnamed: LED9.2 (DOUT), LED10.3 (DIN)
unnamed: LED10.2 (DOUT), LED11.3 (DIN)
unnamed: LED11.2 (DOUT), LED12.3 (DIN)
unnamed: LED12.2 (DOUT), LED18.3 (DIN)
unnamed: LED13.3 (DIN), LED14.2 (DOUT)
unnamed: LED13.2 (DOUT), LED19.3 (DIN)
unnamed: LED14.3 (DIN), LED15.2 (DOUT)
unnamed: LED15.3 (DIN), LED16.2 (DOUT)
unnamed: LED16.3 (DIN), LED17.2 (DOUT)
unnamed: LED17.3 (DIN), LED18.2 (DOUT)
unnamed: LED19.2 (DOUT), LED20.3 (DIN)
unnamed: LED20.2 (DOUT), LED21.3 (DIN)
unnamed: LED21.2 (DOUT), LED22.3 (DIN)
Row 0: D1.1 (K), D2.1 (K), D3.1 (K), D4.1 (K), D5.1 (K), D6.1 (K), U1.7 (4/PD4)
Row 1: D7.1 (K), D8.1 (K), D9.1 (K), D10.1 (K), D11.1 (K), D12.1 (K), U1.8 (5/PC6)
Row 2: D13.1 (K), D14.1 (K), D15.1 (K), D16.1 (K), D17.1 (K), D18.1 (K), U1.9 (6/PD7)
Row 3: D19.1 (K), D20.1 (K), D21.1 (K), D22.1 (K), U1.10 (7/PE6)
SCL: J1.3 (SCL), U1.6 (3/PD0)
SDA: J1.4 (SDA), U1.5 (2/PD1)
TRRS_RX: U1.2 (RX1/PD2), U2.4 (RING2)
TRRS_TX: U1.1 (TX0/PD3), U2.3 (RING1)
VCC: J1.2 (VCC), LED1.1 (VDD), LED2.1 (VDD), LED3.1 (VDD), LED4.1 (VDD), LED5.1 (VDD), LED6.1 (VDD), LED7.1 (VDD), LED8.1 (VDD), LED9.1 (VDD), LED10.1 (VDD), LED11.1 (VDD), LED12.1 (VDD), LED13.1 (VDD), LED14.1 (VDD), LED15.1 (VDD), LED16.1 (VDD), LED17.1 (VDD), LED18.1 (VDD), LED19.1 (VDD), LED20.1 (VDD), LED21.1 (VDD), LED22.1 (VDD), U1.21 (VCC), U2.2 (TIP)

Notes on the sheet:
Left Side: TX - Ring 1 RX - Ring 2 Right Side: RX - Ring 1 TX - Ring 2
Arduino ProMicro
TRRS
LEDs
Key Switches
OLED Display

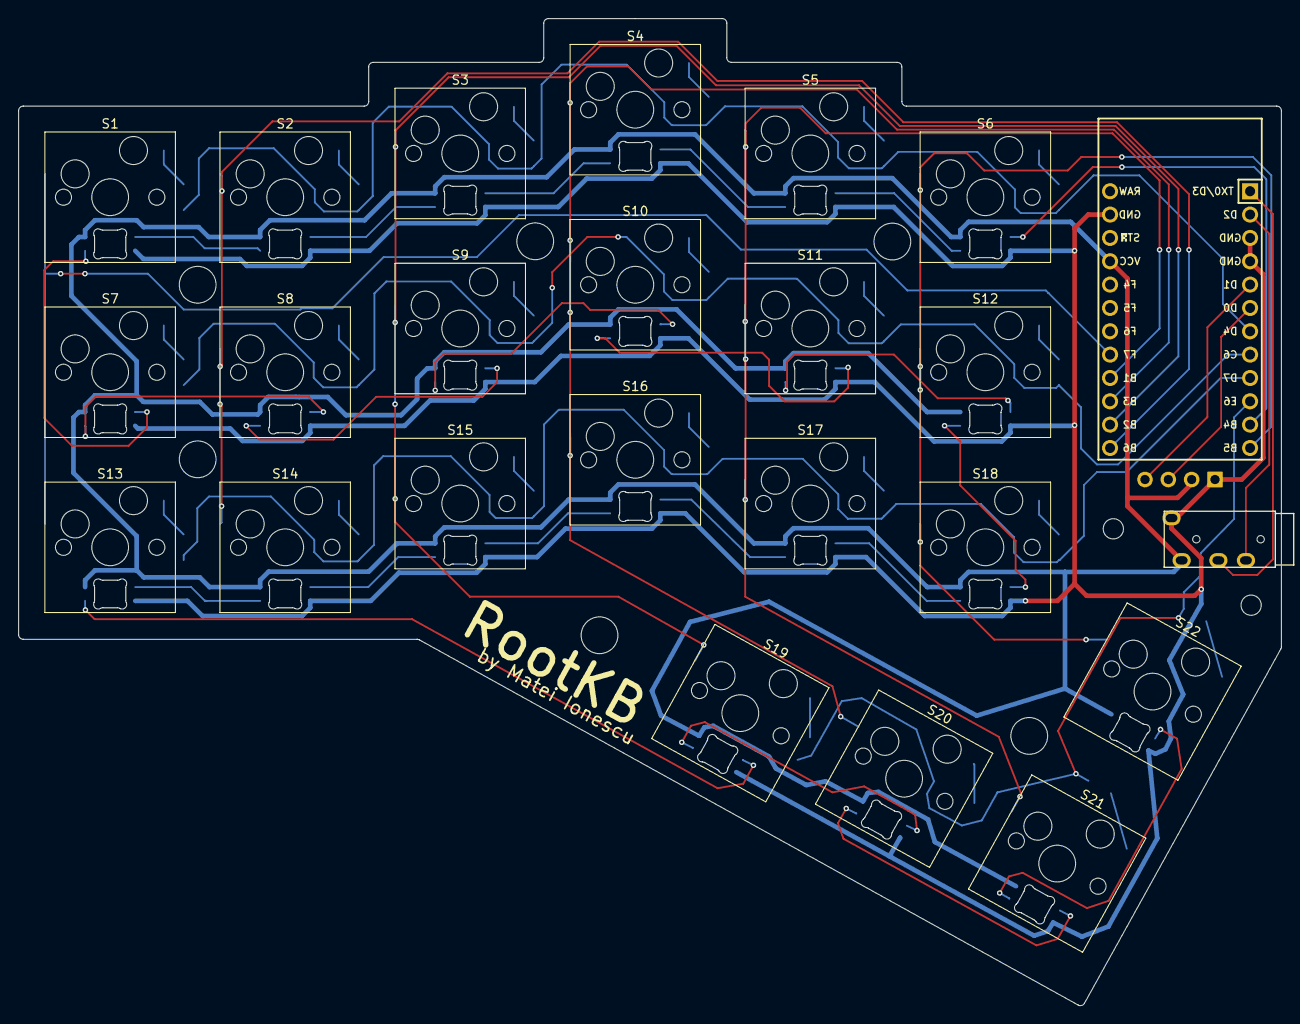
[picture p44: board RootKB-Left.kicad_pcb from above]

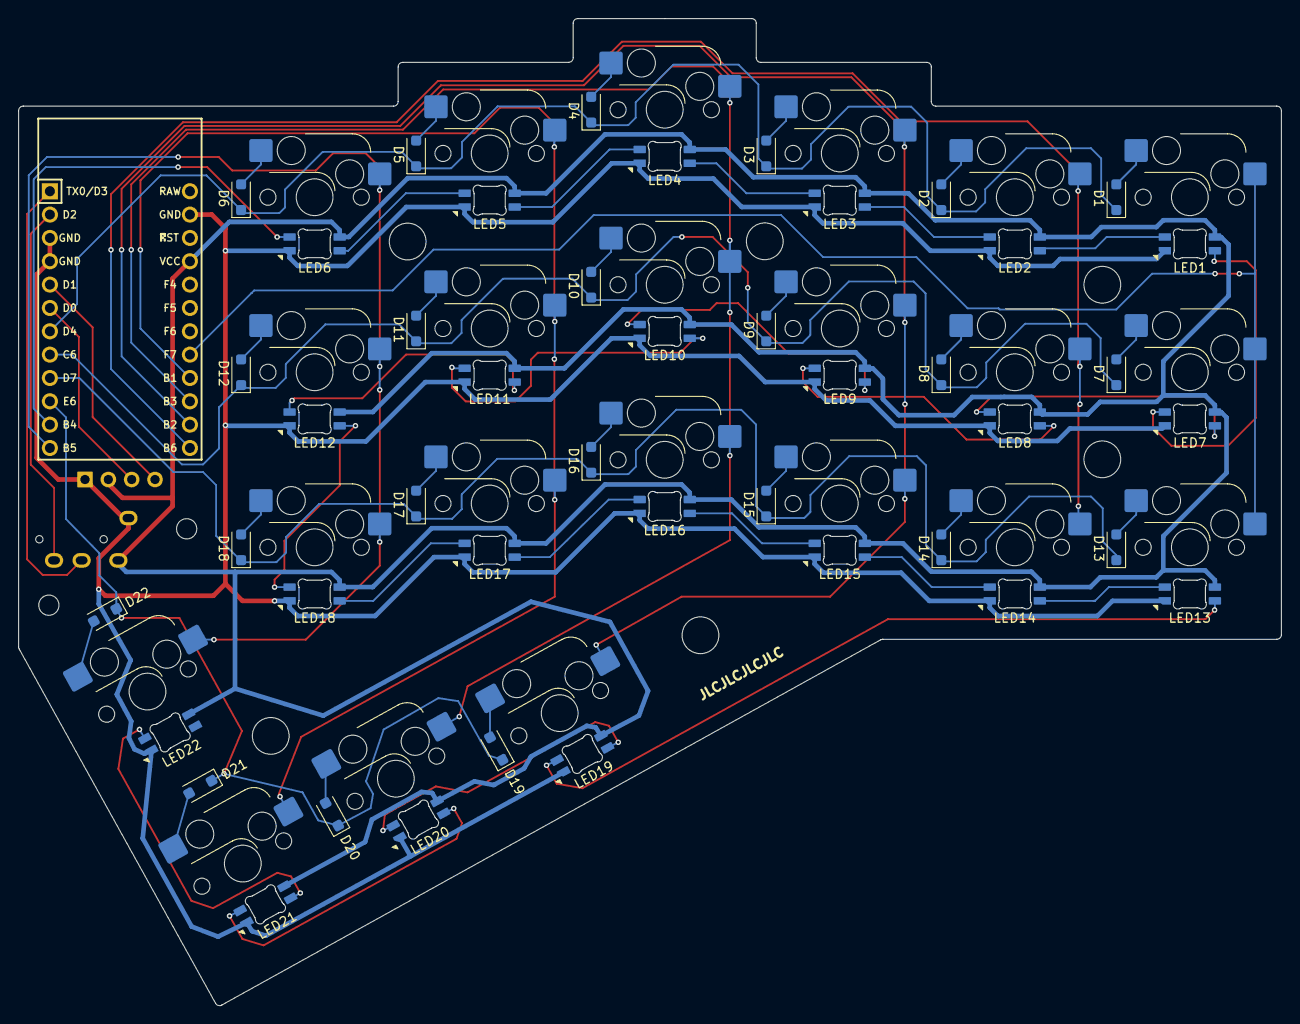
[picture p45: board RootKB-Left.kicad_pcb from below]

Board: 2 copper layers, 137.4 x 107.4 mm, 69 parts (45 on the bottom side), 60 nets.
