Matei77/RootKB/Software/RootKB-Left-Software/src/keys.h

#pragma once

#include <stdint.h>
#include <Arduino.h>
#include <string.h>

#include "matrix.h"

namespace keys {
    const uint8_t LAYERS_NUM = 4;

    void init_keys();
    void send_keys();

    enum raw_keycode_t : uint8_t {
        K_NO = 0,
        K_LAY1 = 1,
        K_LAY2 = 2,
        K_LAY3 = 3,
        K_COLORUP = 4,
        K_COLORDOWN = 5,
        K_BRIGHTUP = 6,
        K_BRIGHTDOWN = 7,
        K_SATUP = 8,
        K_SATDOWN = 9,
        K_MODEUP = 10,
        K_MODEDOWN = 11,
        K_A = 140,
        K_B,
        K_C,
        K_D,
        K_E,
        K_F,
        K_G,
        K_H,
        K_I,
        K_J,
        K_K,
        K_L,
        K_M,
        K_N,
        K_O,
        K_P,
        K_Q,
        K_R,
        K_S,
        K_T,
        K_U,
        K_V,
        K_W,
        K_X,
        K_Y,
        K_Z,
        K_1,
        K_2,
        K_3,
        K_4,
        K_5,
        K_6,
        K_7,
        K_8,
        K_9,
        K_0,
        K_ENTER,
        K_ESC,
        K_BACK,
        K_TAB,
        K_SPACE,
        K_MINUS, // - and _
        K_EQUAL, // = and +
        K_LBRACKET, // [ and {
        K_RBRACKET, // ] and }
        K_BACKSLASH, // \ and |
        K_SEMICOLON = 187, // ; and :
        K_QUOTE, // ' and "
        K_GRAVE, // ` and ~
        K_COMMA, // , and <
        K_PERIOD, // . and >
        K_SLASH, // / and ?
        K_LCTRL = 128,
        K_LSFT,
        K_LALT,
        K_LGUI,
        K_RCTRL,
        K_RSFT,
        K_RALT,
        K_RGUI,
        K_HOME = 210,
        K_END = 213,
        K_DELETE = 212,
        K_RIGHT = 215,
        K_LEFT,
        K_DOWN,
        K_UP,
        K_PRT_SC = 206,
        K_F1 = 194,
        K_F2,
        K_F3,
        K_F4,
        K_F5,
        K_F6,
        K_F7,
        K_F8,
        K_F9,
        K_F10,
        K_F11,
        K_F12,
        K_BL1 = '(',
        K_BR1 = ')',
        K_BL2 = '[',
        K_BR2 = ']',
        K_LCB = '{',
        K_RCB = '}',
        K_CHR11 = '^',
        K_CHR12 = '&',
        K_CHR13 = '_',
        K_CHR14 = '|',
        K_CHR15 = '~',
        K_CHR21 = '=',
        K_CHR22 = '+',
        K_CHR23 = '-',
        K_CHR24 = '*',
        K_CHR25 = '%',
        K_CHR26 = '\\',
        K_CHR31 = '!',
        K_CHR32 = '@',
        K_CHR33 = '#',
        K_CHR34 = '$',
        K_CHR35 = '`',
    };

    extern raw_keycode_t layout[LAYERS_NUM][MATRIX_ROWS][MATRIX_COLS_BOTH];

    const raw_keycode_t initial_layout[LAYERS_NUM][MATRIX_ROWS][MATRIX_COLS_BOTH] = {
        {
            {K_ESC, K_Q, K_W, K_E, K_R, K_T,                K_Y, K_U, K_I, K_O, K_P, K_BACK},
            {K_TAB, K_A, K_S, K_D, K_F, K_G,                K_H, K_J, K_K, K_L, K_SEMICOLON, K_QUOTE},
            {K_LSFT, K_Z, K_X, K_C, K_V, K_B,               K_N, K_M, K_COMMA, K_PERIOD, K_SLASH, K_RSFT},
            {K_NO, K_NO, K_LCTRL, K_SPACE, K_LAY1, K_LGUI,   K_LAY3, K_LAY2, K_ENTER, K_RALT, K_NO, K_NO}
        },

        {
            {K_ESC, K_NO, K_HOME, K_UP, K_END, K_NO,       K_NO, K_BL1, K_BR1, K_NO, K_NO, K_BACK},
            {K_TAB, K_NO, K_LEFT, K_DOWN, K_RIGHT, K_NO,   K_NO, K_LCB, K_RCB, K_NO, K_NO, K_NO},
            {K_LSFT, K_NO, K_NO, K_NO, K_NO, K_NO,         K_NO, K_BL2, K_BR2, K_NO, K_NO, K_RSFT},
            {K_NO, K_NO, K_LCTRL, K_SPACE, K_NO, K_LGUI,    K_NO, K_NO, K_ENTER, K_RALT, K_NO, K_NO}
        },

        {
            {K_ESC, K_NO, K_7, K_8, K_9, K_0,   K_CHR11, K_CHR12, K_CHR13, K_CHR14, K_CHR15, K_DELETE},
            {K_TAB, K_NO, K_4, K_5, K_6, K_NO,   K_CHR21, K_CHR22, K_CHR23, K_CHR24, K_CHR25, K_CHR26},
            {K_LSFT, K_NO, K_1, K_2, K_3, K_NO,   K_CHR31, K_CHR32, K_CHR33, K_CHR34, K_CHR35, K_RSFT},
            {K_NO, K_NO, K_LCTRL, K_SPACE, K_NO,  K_LGUI, K_NO, K_NO, K_ENTER, K_RALT, K_NO, K_NO}
        },

        {
            {K_NO, K_NO, K_F7, K_F8, K_F9, K_F12,   K_BRIGHTUP, K_COLORUP, K_SATUP, K_MODEUP, K_PRT_SC, K_NO},
            {K_NO, K_NO, K_F4, K_F5, K_F6, K_F11,   K_BRIGHTDOWN, K_COLORDOWN, K_SATDOWN, K_MODEDOWN, K_NO, K_NO},
            {K_NO, K_NO, K_F1, K_F2, K_F3, K_F10,   K_NO, K_NO, K_NO, K_NO, K_NO, K_NO},
            {K_NO, K_NO, K_NO, K_NO, K_NO, K_NO,   K_NO, K_NO, K_NO, K_NO, K_NO, K_NO}
        }
    };
    
} // namespace keys
