Matei77/RootKB/(commit log)

2024-04-26 add Ergogen design
    [base_layout.dxf, keys.dxf]
2024-04-26 add KiCad project
    [RootKB.kicad_pcb, RootKB.kicad_sch]
2024-04-27 update pcb
    [RootKB.kicad_pcb, RootKB.kicad_sch]
2024-04-27 move screen cover holes
    [RootKB.kicad_pcb]
2024-04-27 adjust for larger arduino pro micro (Type C)
    [RootKB.kicad_pcb]
2024-04-27 add right side
    [RootKB-Left.kicad_pcb, RootKB-Left.kicad_sch, RootKB-Right.kicad_pcb, RootKB-Right.kicad_sch, RootKB.kicad_pcb, RootKB.kicad_sch]
2024-04-27 update pro micro silkscreen
    [RootKB-Left.kicad_pcb]
2024-04-28 route left
    [RootKB-Left.kicad_pcb, RootKB-Left.kicad_sch]
2024-05-02 routing left
    [RootKB-Left.kicad_pcb, RootKB-Left.kicad_sch]
2024-05-02 remove reset button
    also use real Arduino ProMicro dimensions
    [RootKB-Left.kicad_pcb, RootKB-Left.kicad_sch]
2024-05-02 fix track
    [RootKB-Left.kicad_pcb]
2024-05-02 move vias away from pads
    [RootKB-Left.kicad_pcb]
2024-05-02 update ProMicro silkscreen
    [RootKB-Left.kicad_pcb]
2024-05-04 add jblpcb order number location
    [RootKB-Left.kicad_pcb]
2024-05-05 use UART
    [RootKB-Left.kicad_pcb, RootKB-Left.kicad_sch]
2024-05-05 Make symmetrical right PCB
    [RootKB-Right.kicad_pcb, RootKB-Right.kicad_sch]
2024-05-05 add titles
    [RootKB-Left.kicad_pcb, RootKB-Left.kicad_sch, RootKB-Right.kicad_pcb, RootKB-Right.kicad_sch]
2024-05-05 route tracks on right side
    [RootKB-Right.kicad_pcb, RootKB-Right.kicad_sch]
2024-05-05 update routes
    more clearance for some routes
    [RootKB-Left.kicad_pcb]
2024-05-07 minor routing changes
    [RootKB-Left.kicad_pcb]
2024-05-08 update routing
    [RootKB-Left.kicad_pcb, RootKB-Right.kicad_pcb]
2024-05-08 last updates
    [RootKB-Left.kicad_pcb, RootKB-Left.kicad_sch, RootKB-Right.kicad_pcb, RootKB-Right.kicad_sch]
2024-05-08 add production files
    [bom.csv, designators.csv, positions.csv]
2024-05-11 restructure project
    [RootKB-Left.kicad_pcb, RootKB-Left.kicad_sch, RootKB-Right.kicad_pcb, RootKB-Right.kicad_sch, RootKB.kicad_pcb, RootKB.kicad_sch, bom.csv, designators.csv]
2024-05-11 add plate files
    [RootKB-Plate v7.dwg, RootKB-Plate v7.dxf]
2024-05-12 add casing
    [RootKB-3D-Print-Plate-Left v1.stl, RootKB-3D-Print-Plate-Right v0.stl, RootKB-3D-Print-Plate-Right v1.stl, RootKB-Left-Case v9.step, RootKB-Left-Case v9.stl, RootKB-Left-F_Silkscreen.dxf, RootKB-Plate v7.dwg, RootKB-Plate v8.dwg]
2024-05-12 fix ergogen padding
    [base_layout.dxf, keys.dxf, plate.dxf]
2024-05-27 remove safety button
2025-06-12 request matrix from the other half to avoid sync issues + create rgb modes
    [app_com.cpp, app_com.h, keys.cpp, keys.h, main.cpp, matrix.cpp, oled.cpp, oled.h]
2025-06-12 fix sync issues on rgb mode change
    [matrix.cpp, oled.cpp, oled.h, request.cpp, rgb.cpp]
